Lafayette-FSAE/PacMan/Documentation/ESP32 pinout.png

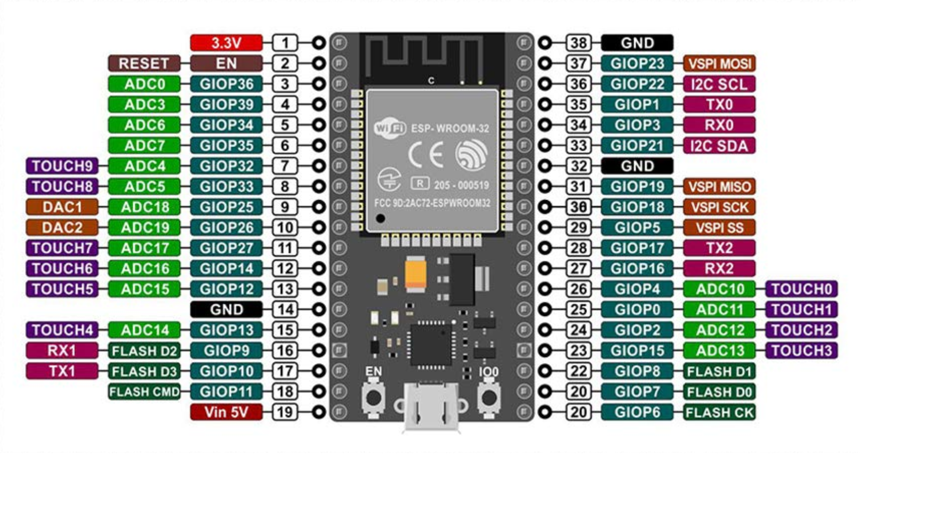
Documentation/ESP32 pinout.png
