Lafayette-FSAE/PacMan/README.md

# PacMan
A KiCad Schematic for PacMan, a Accumulator Management Board for the Lafayette FSAE Accumulator Management System
