Lafayette-FSAE/PacMan/Documentation/PacMan_v_1_3_Render.png

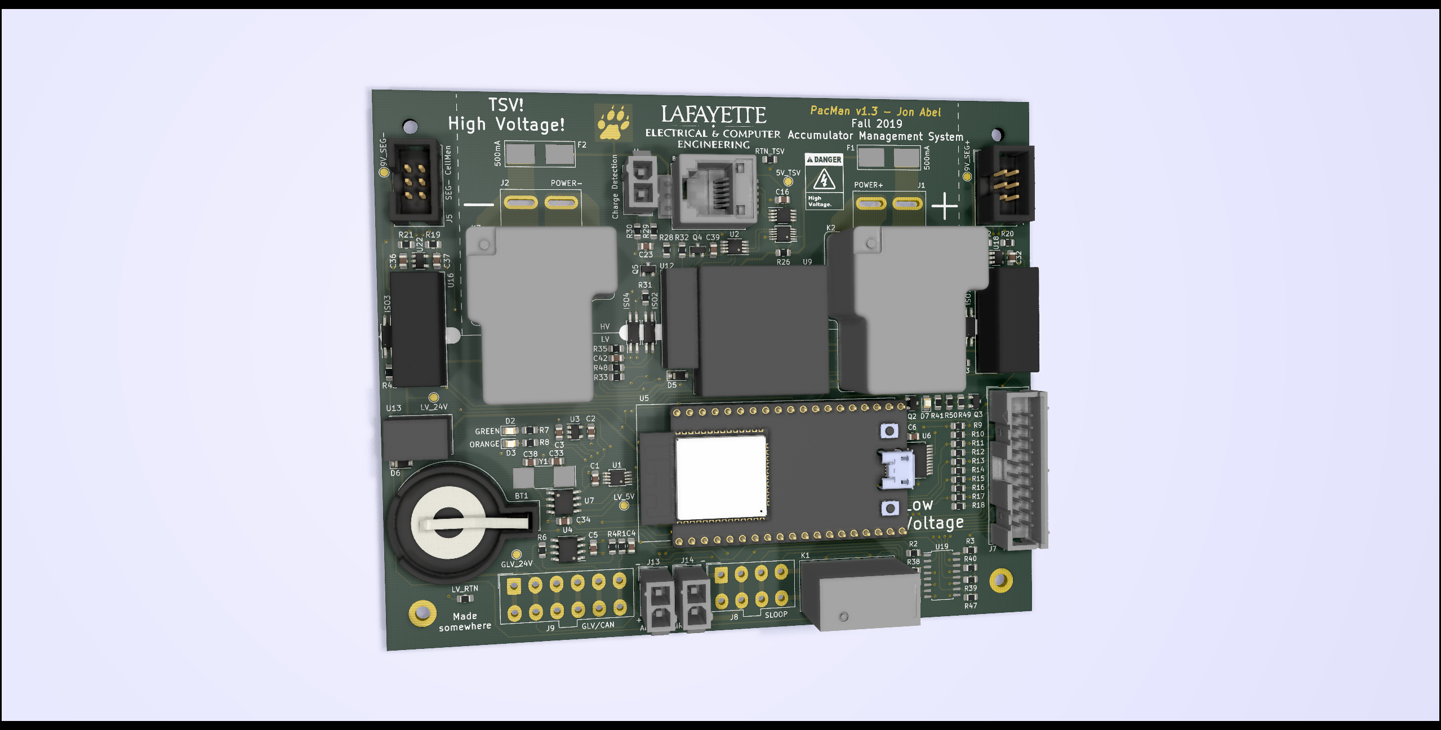
Documentation/PacMan_v_1_3_Render.png
