Lafayette-FSAE/PacMan/Documentation/PacManRender 1.0 Poster.png

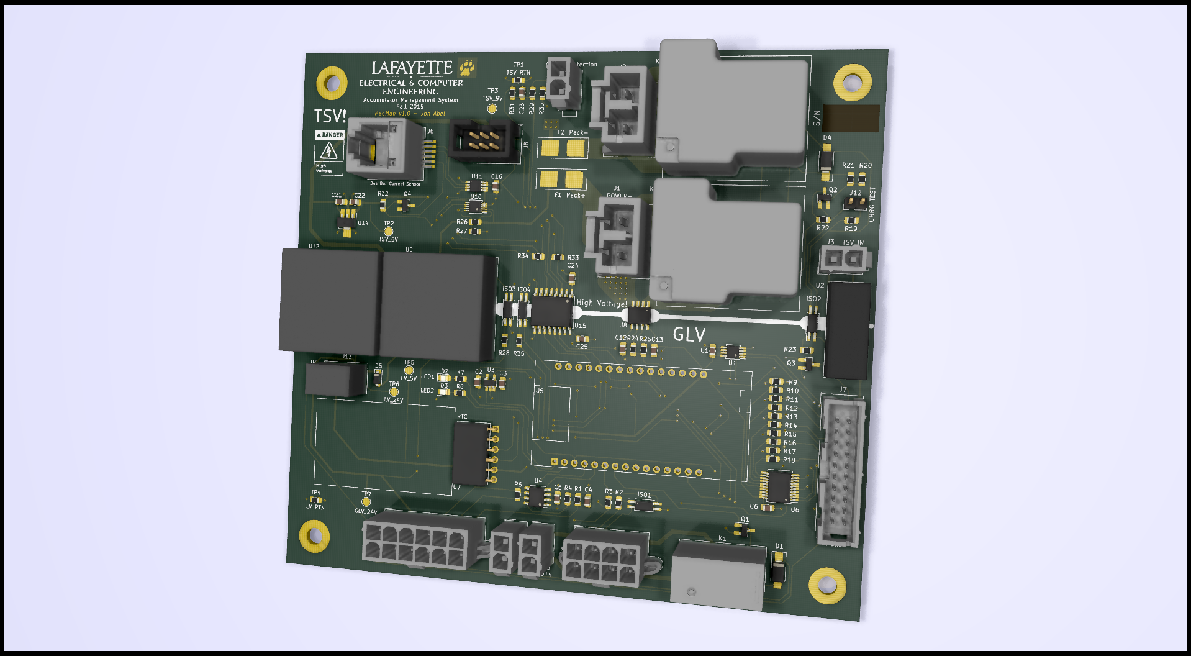
Documentation/PacManRender 1.0 Poster.png
