Lafayette-FSAE/PacMan/Documentation/PacManRender 1.0.png

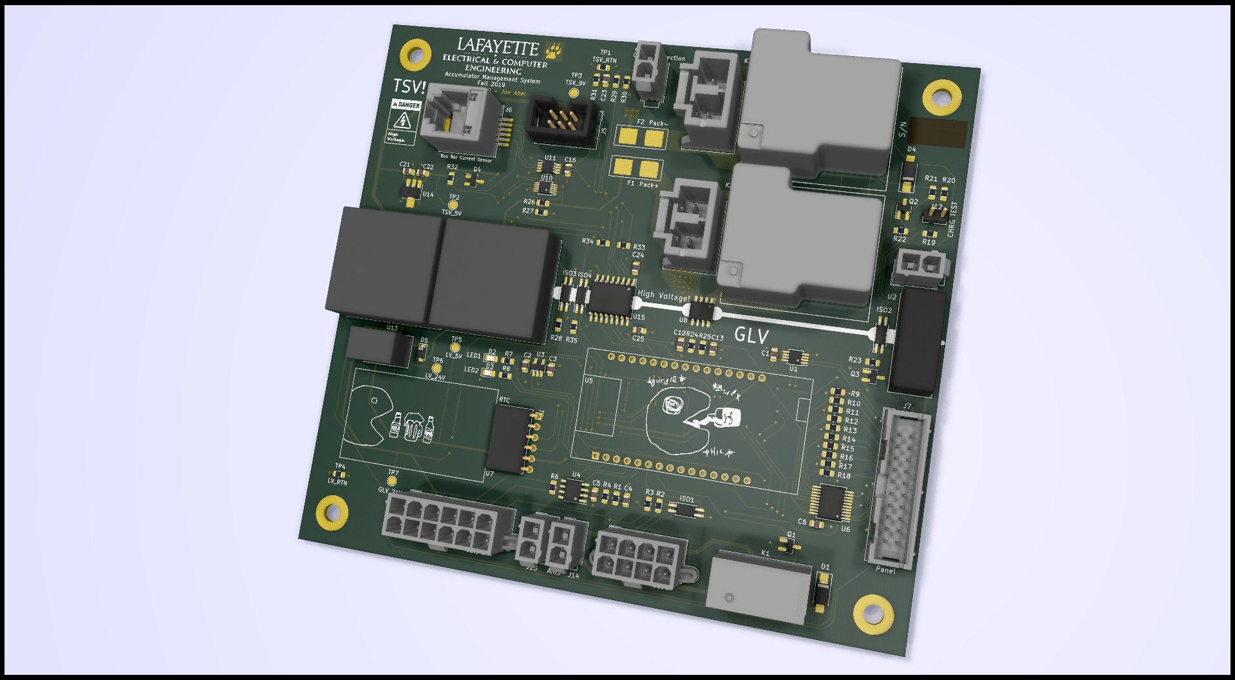
Documentation/PacManRender 1.0.png
