Lafayette-FSAE/PacMan/Documentation/PacMan_v_1_3_BOM.xlsx

BT1 | BR1225 | Battery:BatteryHolder_Keystone_103_1x20mm | Panasonic - BSG | BR-1225 | Digikey | P183-ND | 1
> C4, C42 | C | Capacitor_SMD:C_0805_2012Metric_Pad1.15x1.40mm_HandSolder |  |  |  |  | 2
C12 | 1n/50V | Capacitor_SMD:C_0805_2012Metric_Pad1.15x1.40mm_HandSolder | Samsung Electro-Mechanics | CL21B102KBCNNNC | Digikey | 1276-2425-1-ND | 1
> C13, C30, C34, C36, C40, C41 | 1u/50V | Capacitor_SMD:C_0805_2012Metric_Pad1.15x1.40mm_HandSolder | Samsung Electro-Mechanics | CL21B105KBFNNNG | Digikey | 1276-6470-1-ND | 6
C14 | 4.7u/100V | Capacitor_SMD:C_1210_3225Metric_Pad1.42x2.65mm_HandSolder | Samsung Electro-Mechanics | CL32B475KCVZW6E | Digikey | 1276-7060-1-ND | 1
> C15, C18, C28, C29 | 10u/50V | Capacitor_SMD:C_1210_3225Metric_Pad1.42x2.65mm_HandSolder | Samsung Electro-Mechanics | CL32B106KBJNNWE | Digikey | 1276-3388-1-ND | 4
C19 | 22u/25V | Capacitor_SMD:C_1210_3225Metric_Pad1.42x2.65mm_HandSolder | Samsung Electro-Mechanics | CL32B226KAJNFNE | Digikey | 1276-3391-1-ND | 1
> C24-C27 | 4.7uF/50V | Capacitor_SMD:C_1206_3216Metric_Pad1.42x1.75mm_HandSolder | Samsung Electro-Mechanics | CL31B475KBHNNNE | Digikey | 1276-2789-1-ND | 4
> C32, C37 | 2.2u/25V | Capacitor_SMD:C_0805_2012Metric_Pad1.15x1.40mm_HandSolder | Samsung Electro-Mechanics | CL21B225KAFNFNE | Digikey | 1276-2953-1-ND | 2
> C33, C38 | 20p | Capacitor_SMD:C_0805_2012Metric_Pad1.15x1.40mm_HandSolder | Samsung Electro-Mechanics | CL21C200JBANNNC | Digikey | 1276-1829-1-ND | 2
> C1-C3, C5-C11, C16, C17, C20-C23, C31, C35, C39 | 0.1u/50V | Capacitor_SMD:C_0805_2012Metric_Pad1.15x1.40mm_HandSolder | Samsung Electro-Mechanics | CL21B104KBCNNNC | Digikey | 1276-1003-1-ND | 19
D2 | LED_GREEN | LED_SMD:LED_0805_2012Metric_Pad1.15x1.40mm_HandSolder | Lite-On Inc. | LTST-C170GKT | Digikey | 160-1179-1-ND | 1
D3 | LED_ORANGE | LED_SMD:LED_0805_2012Metric_Pad1.15x1.40mm_HandSolder | Lite-On Inc. | LTST-C171AKT | Digikey | 160-1419-1-ND | 1
> D1, D4 | S1B | Diode_SMD:D_SMA_Handsoldering | Diodes Incorporated | S1B-13-F | Digikey | S1B-FDICT-ND | 2
> D5, D6 | 1N5819HW | Diode_SMD:D_SOD-123 | Diodes Incorporated | 1N5819HW-7-F | Digikey | 1N5819HW-FDICT-ND | 2
D7 | LED_CHRG | LED_SMD:LED_0805_2012Metric_Pad1.15x1.40mm_HandSolder | Lite-On Inc. | LTST-C171AKT | Digikey | 160-1419-1-ND | 1
> F1, F2 | 500mA | Lafayette_Electric_Car_Footprints:0154.500DRL | Littelfuse Inc. | 0154.500DRL | Digikey | F6776CT-ND | 2
> H1, H2 | MountingHole_NoPad_#4 | Lafayette_Electric_Car_Footprints:MountingHole_#4_NoPad |  |  |  |  | 2
> H3, H4 | MountingHole_Pad_#4 | Lafayette_Electric_Car_Footprints:MountingHole_#4_Pad |  |  |  |  | 2
> ISO2-ISO4, ISO7 | TLP293 | Package_SO:SO-4_4.4x2.3mm_P1.27mm | Toshiba Semiconductor | TLP293(GR-TPL,E | Digikey | TLP293(GR-TPLECT-ND | 4
J1 | POWER+ | Lafayette_Electric_Car_Footprints:Powerpole_PP45_FP_1x2 | Anderson Power | 1327FP | Powerwerx | 1327FP | 1
J2 | POWER- | Lafayette_Electric_Car_Footprints:Powerpole_PP45_FP_1x2 | Anderson Power | 1327G6FP | Powerwerx | 1327G6FP | 1
J4 | Charge Detection | Lafayette_Electric_Car_Footprints:Molex_Mini-Fit_Jr_5566-02A_2x01_P4.20mm_Vertical | Molex | 1724470202 | Digikey | WM17931-ND | 1
J5 | SEG- CellMen | Connector_IDC:IDC-Header_2x03_P2.54mm_Vertical | Amphenol ICC | 75869-131LF | Digikey | 609-2845-ND | 1
J6 | BusBar Current Sensor | Lafayette_Electric_Car_Footprints:MOLEX_RJ11 | Molex | 855135002 | Digikey | WM3789CT-ND | 1
J7 | Panel | Lafayette_Electric_Car_Footprints:Amphenol_IDC-Header_2x10_P2.54mm_Vertical | Amphenol ICC | 75869-304LF | Digikey | 609-5118-ND | 1
J8 | SLOOP | Connector_Molex:Molex_Mini-Fit_Jr_5566-08A_2x04_P4.20mm_Vertical | Molex | 39281083 | Digikey | WM3803-ND | 1
J9 | GLV/CAN | Connector_Molex:Molex_Mini-Fit_Jr_5566-12A_2x06_P4.20mm_Vertical | Molex | 39281123 | Digikey | WM3805-ND | 1
J10 | SEG+ CellMen | Connector_IDC:IDC-Header_2x03_P2.54mm_Vertical | Amphenol ICC | 75869-131LF | Digikey | 609-2845-ND | 1
J13 | AIR Left | Lafayette_Electric_Car_Footprints:Molex_Mini-Fit_Jr_5566-02A_2x01_P4.20mm_Vertical | Molex | 1724470202 | Digikey | WM17931-ND | 1
J14 | AIR Right | Lafayette_Electric_Car_Footprints:Molex_Mini-Fit_Jr_5566-02A_2x01_P4.20mm_Vertical | Molex | 1724470202 | Digikey | WM17931-ND | 1
K1 | G5Q-1A4 DC24 | Lafayette_Electric_Car_Footprints:G5Q-1A4 | Omron Electronics | G5Q-1A4 DC24 | Digikey | Z224-ND | 1
> K2, K3 | T9AS1D12-24 | Lafayette_Electric_Car_Footprints:T9AS1D12 | TE Connectivity | T9AS1D12-24 | Digikey | PB303-ND | 2
LOGO1 | LafECEDepLogo | Lafayette_Electric_Car_Footprints:ECE_Logo_Jon |  |  |  |  | 1
LOGO2 | LeopardPawLogo | Lafayette_Electric_Car_Footprints:paw_solder_mask_bigly |  |  |  |  | 1
LOGO3 | DangerHighVoltageLogo | Lafayette_Electric_Car_Footprints:highvoltagesmall |  |  |  |  | 1
> Q1, Q2 | DMN3730U | Package_TO_SOT_SMD:SOT-23 | Diodes Incorporated | DMN3730U-7 | Digikey | DMN3730U-7DICT-ND | 2
> Q3-Q5 | DMP10H4D2S | Package_TO_SOT_SMD:SOT-23 | Diodes Incorporated | DMP10H4D2S-7 | Digikey | DMP10H4D2S-7DICT-ND | 3
R1 | 1M | Resistor_SMD:R_0805_2012Metric_Pad1.15x1.40mm_HandSolder |  |  |  |  | 1
R6 | 120 | Resistor_SMD:R_0805_2012Metric_Pad1.15x1.40mm_HandSolder |  |  |  |  | 1
> R7, R8, R42, R43 | 270 | Resistor_SMD:R_0805_2012Metric_Pad1.15x1.40mm_HandSolder |  |  |  |  | 4
> R9, R11, R13, R15, R17, R28 | 100k | Resistor_SMD:R_0805_2012Metric_Pad1.15x1.40mm_HandSolder |  |  |  |  | 6
> R19-R23, R27, R44, R45 | 3.3k | Resistor_SMD:R_0805_2012Metric_Pad1.15x1.40mm_HandSolder |  |  |  |  | 8
> R3, R24, R32, R33, R36, R37, R39, R40, R47 | 10k | Resistor_SMD:R_0805_2012Metric_Pad1.15x1.40mm_HandSolder |  |  |  |  | 9
R25 | 22k | Resistor_SMD:R_0805_2012Metric_Pad1.15x1.40mm_HandSolder |  |  |  |  | 1
R26 | 0.82 | Resistor_SMD:R_0805_2012Metric_Pad1.15x1.40mm_HandSolder | Panasonic Electronic Components | ERJ-6DQFR82V | Digikey | P19306CT-ND | 1
> R29, R30 | 5k | Resistor_SMD:R_0805_2012Metric_Pad1.15x1.40mm_HandSolder |  |  |  |  | 2
R31 | 330 | Resistor_SMD:R_0805_2012Metric_Pad1.15x1.40mm_HandSolder |  |  |  |  | 1
R34 | 470 | Resistor_SMD:R_0805_2012Metric_Pad1.15x1.40mm_HandSolder |  |  |  |  | 1
> R2, R5, R35, R38, R46 | 5.1k | Resistor_SMD:R_0805_2012Metric_Pad1.15x1.40mm_HandSolder |  |  |  |  | 5
> R4, R10, R12, R14, R16, R18, R41 | 1k | Resistor_SMD:R_0805_2012Metric_Pad1.15x1.40mm_HandSolder |  |  |  |  | 7
R48 | R | Resistor_SMD:R_0805_2012Metric_Pad1.15x1.40mm_HandSolder |  |  |  |  | 1
> R49, R50 | 4.7k | Resistor_SMD:R_0805_2012Metric_Pad1.15x1.40mm_HandSolder |  |  |  |  | 2
TP1 | 5V_SEG- | TestPoint:TestPoint_Pad_D1.5mm |  |  |  |  | 1
TP2 | RTN_SEG- | Resistor_SMD:R_0805_2012Metric_Pad1.15x1.40mm_HandSolder | TE Connectivity | RCT-0C | Digikey | A106144CT-ND | 1
TP3 | 9V_SEG- | TestPoint:TestPoint_Pad_D1.5mm |  |  |  |  | 1
TP4 | LV_RTN | Resistor_SMD:R_0805_2012Metric_Pad1.15x1.40mm_HandSolder | TE Connectivity | RCT-0C | Digikey | A106144CT-ND | 1
TP5 | LV_5V | TestPoint:TestPoint_Pad_D1.5mm |  |  |  |  | 1
TP6 | LV_24V | TestPoint:TestPoint_Pad_D1.5mm |  |  |  |  | 1
TP7 | GLV_24V | TestPoint:TestPoint_Pad_D1.5mm |  |  |  |  | 1
TP8 | SDA | TestPoint:TestPoint_Pad_D1.5mm |  |  |  |  | 1
TP9 | SCL | TestPoint:TestPoint_Pad_D1.5mm |  |  |  |  | 1
TP10 | 5V_TSV | TestPoint:TestPoint_Pad_D1.5mm |  |  |  |  | 1
TP11 | RTN_TSV | Resistor_SMD:R_0805_2012Metric_Pad1.15x1.40mm_HandSolder | TE Connectivity | RCT-0C | Digikey | A106144CT-ND | 1
TP12 | 9V_SEG+ | TestPoint:TestPoint_Pad_D1.5mm |  |  |  |  | 1
TP13 | 5V_SEG+ | TestPoint:TestPoint_Pad_D1.5mm |  |  |  |  | 1
TP14 | RTN_SEG+ | Resistor_SMD:R_0805_2012Metric_Pad1.15x1.40mm_HandSolder | TE Connectivity | RCT-0C | Digikey | A106144CT-ND | 1
> U1, U2 | MCP9804 | Package_SO:MSOP-8_3x3mm_P0.65mm | Microchip Technology | MCP9804T-E/MS | Digikey | MCP9804T-E/MSCT-ND | 2
U3 | ADM6320 | Package_TO_SOT_SMD:SOT-23-5 | Analog Devices Inc. | ADM6320CY29ARJZ-R7 | Digikey | ADM6320CY29ARJZ-R7CT-ND | 1
U4 | MCP2551-I-SN | Package_SO:SOIC-8_3.9x4.9mm_P1.27mm | Microchip Technology | MCP2551T-I/SN | Digikey | MCP2551T-I/SNCT-ND | 1
U5 | ESP32_DEVKITC | Lafayette_Electric_Car_Footprints:MODULE_ESP32-DEVKITC-32D | Espressif Systems | ESP32-DEVKITC-32D | Digikey | 1965-1000-ND | 1
U6 | MCP23008 | Package_SO:SSOP-20_5.3x7.2mm_P0.65mm | Microchip Technology | MCP23008T-E/SS | Digikey | MCP23008T-E/SSCT-ND | 1
U7 | BQ32002 | Package_SO:SOIC-8_3.9x4.9mm_P1.27mm | Texas Instruments | BQ32002DR | Digikey | 296-41071-1-ND | 1
U8 | ACHS-7122 | Package_SO:SO-8_3.9x4.9mm_P1.27mm | Broadcom Limited | ACHS-7122-000E | Digikey | 516-4081-ND | 1
U9 | PDQE10-Q48-S24-D | Lafayette_Electric_Car_Footprints:PDQE10-DIP6 | CUI Inc. | PDQE10-Q48-S24-D | Digikey | 102-4874-ND | 1
U10 | LTC4151 | Package_SO:MSOP-10_3x3mm_P0.5mm | Linear Technology/Analog Devices | LTC4151IMS#TRPBF | Digikey | LTC4151IMS#TRPBFCT-ND | 1
U11 | INA592 | Package_SO:VSSOP-8_3.0x3.0mm_P0.65mm | Texas Instruments | INA592IDGKR | Digikey | 296-INA592IDGKRCT-ND | 1
U12 | MEF1S2405SP3C | Lafayette_Electric_Car_Footprints:MEF1S2405SP3C | Murata Power Solutions Inc. | MEF1S2405SP3C | Digikey | 811-2932-5-ND | 1
U13 | V7805-500 | Lafayette_Electric_Car_Footprints:VX7805-500 | CUI Inc. | V7805-500 | Digikey | 102-1709-ND | 1
> U14, U15, U21 | Si8600AC | Package_SO:SO-8_3.9x4.9mm_P1.27mm | Silicon Labs | SI8600AC-B-ISR | Digikey | SI8600AC-B-ISRCT-ND | 3
> U16, U17 | TEC3-2419 | Lafayette_Electric_Car_Footprints:TEC3-2419 | Traco Power | TEC 3-2419 | Digikey | 1951-1481-ND | 2
> U18, U22 | AP2204K-5.0 | Package_TO_SOT_SMD:SOT-23-5 | Diodes Incorporated | AP2204K-5.0TRG1 | Digikey | AP2204K-5.0TRG1DICT-ND | 2
U19 | TLP293-4 | Package_SO:SOIC-16_4.55x10.3mm_P1.27mm | Toshiba Semiconductor | TLP293-4 | Digikey |  | 1
Y1 | 32K | Crystal:Crystal_SMD_SeikoEpson_MC405-2Pin_9.6x4.1mm | Seiko Epson | MC-405 32.7680K-A0:ROHS | Digikey | SER2405CT-ND | 1
