Lafayette-FSAE/PacMan/Documentation/BOM 1.0.xlsx

C4 | C | Capacitor_SMD:C_0805_2012Metric_Pad1.15x1.40mm_HandSolder | ~ |  |  |  |  | 1
> C1-C3, C5-C11, C16, C22-C25 | 0.1u/50V | Capacitor_SMD:C_0805_2012Metric_Pad1.15x1.40mm_HandSolder | http://www.samsungsem.com/kr/support/product-search/mlcc/__icsFiles/afieldfile/2019/06/18/CL21B104KBCNNNC-19.pdf | Samsung Electro-Mechanics | CL21B104KBCNNNC | Digikey | 1276-1003-1-ND | 15
C12 | 1n/50V | Capacitor_SMD:C_0805_2012Metric_Pad1.15x1.40mm_HandSolder | http://www.samsungsem.com/kr/support/product-search/mlcc/__icsFiles/afieldfile/2019/06/18/CL21B102KBCNNNC-19.pdf | Samsung Electro-Mechanics | CL21B102KBCNNNC | Digikey | 1276-2425-1-ND | 1
C13 | 1u/50V | Capacitor_SMD:C_0805_2012Metric_Pad1.15x1.40mm_HandSolder | http://www.samsungsem.com/kr/support/product-search/mlcc/__icsFiles/afieldfile/2019/06/18/CL21B105KBFNNNG-19.pdf | Samsung Electro-Mechanics | CL21B105KBFNNNG | Digikey | 1276-6470-1-ND | 1
C14 | 4.7u/100V | Capacitor_SMD:C_0805_2012Metric_Pad1.15x1.40mm_HandSolder | http://www.samsungsem.com/kr/support/library/product-catalog/__icsFiles/afieldfile/2018/11/28/MLCC.pdf | Samsung Electro-Mechanics | CL32B475KCVZW6E | Digikey | 1276-7060-1-ND | 1
> C15, C18, C20 | 10u/50V | Capacitor_SMD:C_1210_3225Metric_Pad1.42x2.65mm_HandSolder | http://www.samsungsem.com/kr/support/product-search/mlcc/__icsFiles/afieldfile/2019/06/18/CL32B106KBJNNWE-19.pdf | Samsung Electro-Mechanics | CL32B106KBJNNWE | Digikey | 1276-3388-1-ND | 3
C17 | 22u/50V | Capacitor_SMD:C_0805_2012Metric_Pad1.15x1.40mm_HandSolder | http://www.samsungsem.com/kr/support/product-search/mlcc/__icsFiles/afieldfile/2019/05/10/19-CL21A475KBQNNNE.pdf | Samsung Electro-Mechanics | CL21A475KBQNNNE | Digikey | 1276-1248-1-ND | 1
C19 | 22u/25V | Capacitor_SMD:C_1210_3225Metric_Pad1.42x2.65mm_HandSolder | http://www.samsungsem.com/kr/support/product-search/mlcc/__icsFiles/afieldfile/2019/06/18/CL32B226KAJNFNE-19.pdf | Samsung Electro-Mechanics | CL32B226KAJNFNE | Digikey | 1276-3391-1-ND | 1
C21 | 0.33u/50V | Capacitor_SMD:C_0805_2012Metric_Pad1.15x1.40mm_HandSolder | http://www.samsungsem.com/kr/support/product-search/mlcc/__icsFiles/afieldfile/2019/06/18/CL21B334KBFNNNE-19.pdf | Samsung Electro-Mechanics | CL21B334KBFNNNE | Digikey | 1276-1123-1-ND | 1
> D1, D4 | S1B | Diode_SMD:D_SMA_Handsoldering | https://www.diodes.com/assets/Datasheets/ds16003.pdf | Diodes Incorporated | S1B-13-F | Digikey | S1B-FDICT-ND | 2
D2 | LED_GREEN | LED_SMD:LED_0805_2012Metric_Pad1.15x1.40mm_HandSolder | https://media.digikey.com/pdf/Data%20Sheets/Lite-On%20PDFs/LTST-C170GKT.pdf | Lite-On Inc. | LTST-C170GKT | Digikey | 160-1179-1-ND | 1
D3 | LED_ORANGE | LED_SMD:LED_0805_2012Metric_Pad1.15x1.40mm_HandSolder | http://optoelectronics.liteon.com/upload/download/DS-22-99-0170/LTST-C171AKT.pdf | Lite-On Inc. | LTST-C171AKT | Digikey | 160-1419-1-ND | 1
> D5, D6 | 1N5819HW | Diode_SMD:D_SOD-123 | https://www.diodes.com/assets/Datasheets/ds30217.pdf | Diodes Incorporated | 1N5819HW-7-F | Digikey | 1N5819HW-FDICT-ND | 2
F1 | Pack+ | Lafayette_Electric_Car_Footprints:0154.500DRL | https://www.littelfuse.com/~/media/electronics/datasheets/fuses/littelfuse_fuse_154_154t_154l_154tl_datasheet.pdf.pdf | Littelfuse Inc. | 0154.500DRL | Digikey | F6776CT-ND | 1
F2 | Pack- | Lafayette_Electric_Car_Footprints:0154.500DRL | https://www.littelfuse.com/~/media/electronics/datasheets/fuses/littelfuse_fuse_154_154t_154l_154tl_datasheet.pdf.pdf | Littelfuse Inc. | 0154.500DRL | Digikey | F6776CT-ND | 1
> H1-H4 | MountingHole_Pad | MountingHole:MountingHole_4.3mm_M4_Pad | ~ |  |  |  |  | 4
> ISO1-ISO4 | TLP293 | Package_SO:SO-4_4.4x2.3mm_P1.27mm | https://toshiba.semicon-storage.com/info/docget.jsp?did=14419&prodName=TLP293 | Toshiba Semiconductor | TLP293(GR-TPL,E | Digikey | TLP293(GR-TPLECT-ND | 4
J1 | POWER+ | Lafayette_Electric_Car_Footprints:DF22-2P-7.92 | https://www.hirose.com/product/document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 | Hirose Electric Co | DF22L-2P-7.92DSA(05) | Digikey | H10722-ND | 1
J2 | POWER- | Lafayette_Electric_Car_Footprints:DF22-2P-7.92 | https://www.hirose.com/product/document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 | Hirose Electric Co | DF22R-2P-7.92DSA(05) | Digikey | H10718-ND | 1
J3 | TSV IN | Lafayette_Electric_Car_Footprints:Molex_Mini-Fit_Jr_5566-02A_2x01_P4.20mm_Vertical | https://www.molex.com/webdocs/datasheets/pdf/en-us/1724470202_PCB_HEADERS.pdf | Molex | 1724470202 | Digikey | WM17931-ND | 1
J4 | Charge Detection | Lafayette_Electric_Car_Footprints:Molex_Mini-Fit_Jr_5566-02A_2x01_P4.20mm_Vertical | https://www.molex.com/webdocs/datasheets/pdf/en-us/1724470202_PCB_HEADERS.pdf | Molex | 1724470202 | Digikey | WM17931-ND | 1
J5 | CellMen | Connector_IDC:IDC-Header_2x03_P2.54mm_Vertical | https://cdn.amphenol-icc.com/media/wysiwyg/files/drawing/75869.pdf | Amphenol ICC | 75869-131LF | Digikey | 609-2845-ND | 1
J6 | RJ12 | Lafayette_Electric_Car_Footprints:MOLEX_RJ11 | https://www.molex.com/pdm_docs/sd/855135002_sd.pdf | Molex | 855135002 | Digikey | WM3789CT-ND | 1
J7 | Panel | Lafayette_Electric_Car_Footprints:Amphenol_IDC-Header_2x10_P2.54mm_Vertical | https://cdn.amphenol-icc.com/media/wysiwyg/files/drawing/75869.pdf | Amphenol ICC | 75869-304LF | Digikey | 609-5118-ND | 1
J8 | SLOOP | Lafayette_Electric_Car_Footprints:Molex_Mini-Fit_Jr_5566-08A2_2x04_P4.20mm_Vertical | https://www.molex.com/pdm_docs/sd/1724470002_sd.pdf | Molex | 1724470008 | Digikey | WM20746-ND | 1
J9 | GLV/CAN | Lafayette_Electric_Car_Footprints:Molex_Mini-Fit_Jr_5566-12A2_2x06_P4.20mm_Vertical | https://www.molex.com/pdm_docs/sd/462070012_sd.pdf | Molex | 462070012 | Digikey | 23-0462070012-ND | 1
J12 | CHRG TEST | Connector_PinHeader_2.54mm:PinHeader_1x02_P2.54mm_Vertical | ~ |  |  |  |  | 1
J13 | AIR Left | Lafayette_Electric_Car_Footprints:Molex_Mini-Fit_Jr_5566-02A_2x01_P4.20mm_Vertical | https://www.molex.com/webdocs/datasheets/pdf/en-us/1724470202_PCB_HEADERS.pdf | Molex | 1724470202 | Digikey | WM17931-ND | 1
J14 | AIR Right | Lafayette_Electric_Car_Footprints:Molex_Mini-Fit_Jr_5566-02A_2x01_P4.20mm_Vertical | https://www.molex.com/webdocs/datasheets/pdf/en-us/1724470202_PCB_HEADERS.pdf | Molex | 1724470202 | Digikey | WM17931-ND | 1
K1 | G5Q-1A4 DC24 | Lafayette_Electric_Car_Footprints:G5Q-1A4 | https://omronfs.omron.com/en_US/ecb/products/pdf/en-g5q.pdf | Omron Electronics | G5Q-1A4 DC24 | Digikey | Z224-ND | 1
> K2, K3 | T9AS1D12-48 | Lafayette_Electric_Car_Footprints:T9AS1D12 | https://www.te.com/commerce/DocumentDelivery/DDEController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 | TE Connectivity | T9AS1D12-48 | Digikey | PB1013-ND | 2
LOGO1 | LafECEDepLogo | Lafayette_Electric_Car_Footprints:ECE_Logo_Jon |  |  |  |  |  | 1
LOGO2 | LeopardPawLogo | Lafayette_Electric_Car_Footprints:paw_solder_mask_larger |  |  |  |  |  | 1
LOGO3 | DangerHighVoltageLogo | Lafayette_Electric_Car_Footprints:highvoltagesmall |  |  |  |  |  | 1
> Q1, Q3 | BSS123 | Package_TO_SOT_SMD:SOT-23_Handsoldering | https://www.diodes.com/assets/Datasheets/ds30366.pdf | Diodes Incorporated | BSS123-7-F | Digikey | BSS123-FDICT-ND | 2
> Q2, Q4 | DMP10H4D2S | Package_TO_SOT_SMD:SOT-23_Handsoldering | https://www.diodes.com/assets/Datasheets/DMP10H4D2S.pdf | Diodes Incorporated | DMP10H4D2S-7 | Digikey | DMP10H4D2S-7DICT-ND | 2
R1 | 1M | Resistor_SMD:R_0805_2012Metric_Pad1.15x1.40mm_HandSolder | ~ |  |  |  |  | 1
> R2, R28, R33-R37 | 4.7k | Resistor_SMD:R_0805_2012Metric_Pad1.15x1.40mm_HandSolder | ~ |  |  |  |  | 7
> R3, R24, R32 | 10k | Resistor_SMD:R_0805_2012Metric_Pad1.15x1.40mm_HandSolder | ~ |  |  |  |  | 3
> R4, R10, R12, R14, R16, R18, R22 | 1k | Resistor_SMD:R_0805_2012Metric_Pad1.15x1.40mm_HandSolder | ~ |  |  |  |  | 7
R6 | 120 | Resistor_SMD:R_0805_2012Metric_Pad1.15x1.40mm_HandSolder | ~ |  |  |  |  | 1
> R7, R8 | 270 | Resistor_SMD:R_0805_2012Metric_Pad1.15x1.40mm_HandSolder | ~ |  |  |  |  | 2
> R9, R11, R13, R15, R17 | 100k | Resistor_SMD:R_0805_2012Metric_Pad1.15x1.40mm_HandSolder | ~ |  |  |  |  | 5
R19 | 15k | Resistor_SMD:R_0805_2012Metric_Pad1.15x1.40mm_HandSolder | ~ |  |  |  |  | 1
> R20, R21 | 560 | Resistor_SMD:R_0805_2012Metric_Pad1.15x1.40mm_HandSolder | ~ |  |  |  |  | 2
R23 | 390 | Resistor_SMD:R_0805_2012Metric_Pad1.15x1.40mm_HandSolder | ~ |  |  |  |  | 1
R25 | 22k | Resistor_SMD:R_0805_2012Metric_Pad1.15x1.40mm_HandSolder | ~ |  |  |  |  | 1
R26 | 0.82 | Resistor_SMD:R_0805_2012Metric_Pad1.15x1.40mm_HandSolder | https://industrial.panasonic.com/cdbs/www-data/pdf/RDN0000/AOA0000C313.pdf | Panasonic Electronic Components | ERJ-6DQFR82V | Digikey | P19306CT-ND | 1
R27 | R | Resistor_SMD:R_0805_2012Metric_Pad1.15x1.40mm_HandSolder | ~ |  |  |  |  | 1
> R29, R30 | 5k | Resistor_SMD:R_0805_2012Metric_Pad1.15x1.40mm_HandSolder | ~ |  |  |  |  | 2
R31 | 500k | Resistor_SMD:R_0805_2012Metric_Pad1.15x1.40mm_HandSolder | ~ |  |  |  |  | 1
TP1 | TP_TSV_RTN | Resistor_SMD:R_0805_2012Metric_Pad1.15x1.40mm_HandSolder | https://www.te.com/commerce/DocumentDelivery/DDEController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 | TE Connectivity | RCT-0C | Digikey | A106144CT-ND | 1
TP2 | TP_TSV_5V | TestPoint:TestPoint_Pad_D2.0mm | ~ |  |  |  |  | 1
TP3 | TP_TSV_9V | TestPoint:TestPoint_Pad_D2.0mm | ~ |  |  |  |  | 1
TP4 | TP_LV_RTN | Resistor_SMD:R_0805_2012Metric_Pad1.15x1.40mm_HandSolder | https://www.te.com/commerce/DocumentDelivery/DDEController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 | TE Connectivity | RCT-0C | Digikey | A106144CT-ND | 1
TP5 | TP_LV_5V | TestPoint:TestPoint_Pad_D2.0mm | ~ |  |  |  |  | 1
TP6 | TP_LV_24V | TestPoint:TestPoint_Pad_D2.0mm | ~ |  |  |  |  | 1
TP7 | TP_GLV_24V | TestPoint:TestPoint_Pad_D2.0mm | ~ |  |  |  |  | 1
U1 | MCP9804 | Package_SO:MSOP-8_3x3mm_P0.65mm | http://ww1.microchip.com/downloads/en/DeviceDoc/22203b.pdf | Microchip Technology | MCP9804T-E/MS | Digikey | MCP9804T-E/MSCT-ND | 1
U2 | TEC2-4815WI | Lafayette_Electric_Car_Footprints:TEC2-4815 | https://www.tracopower.com/products/tec2wi.pdf | Traco Power | TEC 2-4815WI | Digikey | 1951-1435-ND | 1
U3 | ADM6320 | Package_TO_SOT_SMD:SOT-23-5_HandSoldering | https://www.analog.com/media/en/technical-documentation/data-sheets/ADM6316_6318_6319_6320_6321_6322.pdf | Analog Devices Inc. | ADM6320CY29ARJZ-R7 | Digikey | ADM6320CY29ARJZ-R7CT-ND | 1
U4 | MCP2551-I-SN | Package_SO:SOIC-8_3.9x4.9mm_P1.27mm | http://ww1.microchip.com/downloads/en/devicedoc/21667d.pdf | Microchip Technology | MCP2551T-I/SN | Digikey | MCP2551T-I/SNCT-ND | 1
U5 | ESP32_TTGO_PSRAM | Lafayette_Electric_Car_Footprints:ESP32TTGOT8 | https://www.amazon.com/TTGO-ESP32-PSRAM-Antenna-Bluetooth/dp/B07B6NM1RY |  |  |  |  | 1
U6 | MCP23008 | Package_SO:SSOP-20_5.3x7.2mm_P0.65mm | https://www.mouser.com/datasheet/2/268/21919b-65915.pdf | Microchip Technology | MCP23008T-E/SS | Digikey | MCP23008T-E/SSCT-ND | 1
U7 | RTC | Connector_PinSocket_2.54mm:PinSocket_1x06_P2.54mm_Horizontal | ~ |  |  |  |  | 1
U8 | ACHS-7122 | Package_SO:SO-8_3.9x4.9mm_P1.27mm | https://www.mouser.com/datasheet/2/678/ACHS-712x-DS101_2018-02-28-1386725.pdf | Broadcom Limited | ACHS-7122-000E | Digikey | 516-4081-ND | 1
U9 | PDQE10-Q48-S24-D | Lafayette_Electric_Car_Footprints:PDQE10-DIP6 | https://www.cui.com/product/resource/pdqe10-d.pdf | CUI Inc. | PDQE10-Q48-S24-D | Digikey | 102-4874-ND | 1
U10 | LTC4151 | Package_SO:MSOP-10_3x3mm_P0.5mm | https://www.analog.com/media/en/technical-documentation/data-sheets/4151ff.pdf | Linear Technology/Analog Devices | LTC4151IMS#TRPBF | Digikey | LTC4151IMS#TRPBFCT-ND | 1
U11 | INA592 | Package_SO:VSSOP-8_3.0x3.0mm_P0.65mm | http://www.ti.com/lit/ds/symlink/ina592.pdf | Texas Instruments | INA592IDGKR | Digikey | 296-INA592IDGKRCT-ND | 1
U12 | PDQE10-Q24-S9-D | Lafayette_Electric_Car_Footprints:PDQE10-DIP6 | https://www.cui.com/product/resource/pdqe10-d.pdf | CUI Inc. | PDQE10-Q24-S9-D | Digikey | 102-4862-ND | 1
U13 | V7805-500 | Lafayette_Electric_Car_Footprints:VX7805-500 | https://www.cui.com/product/resource/v78-500.pdf | CUI Inc. | V7805-500 | Digikey | 102-1709-ND | 1
U14 | L78L05_SOT89 | Package_TO_SOT_SMD:SOT-89-3_Handsoldering | http://www.st.com/content/ccc/resource/technical/document/datasheet/15/55/e5/aa/23/5b/43/fd/CD00000446.pdf/files/CD00000446.pdf/jcr:content/translations/en.CD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 | STMicroelectronics | L78L05ACUTR | Digikey | 497-1183-1-ND | 1
U15 | Si8605AD-B-IS | Package_SO:SOIC-16W_7.5x10.3mm_P1.27mm | https://www.silabs.com/documents/public/data-sheets/Si860x.pdf | Silicon Labs | SI8605AD-B-ISR | Digikey | 336-4928-1-ND | 1
