Lafayette-FSAE/PacMan/3DModels/Anderson_2x1.step

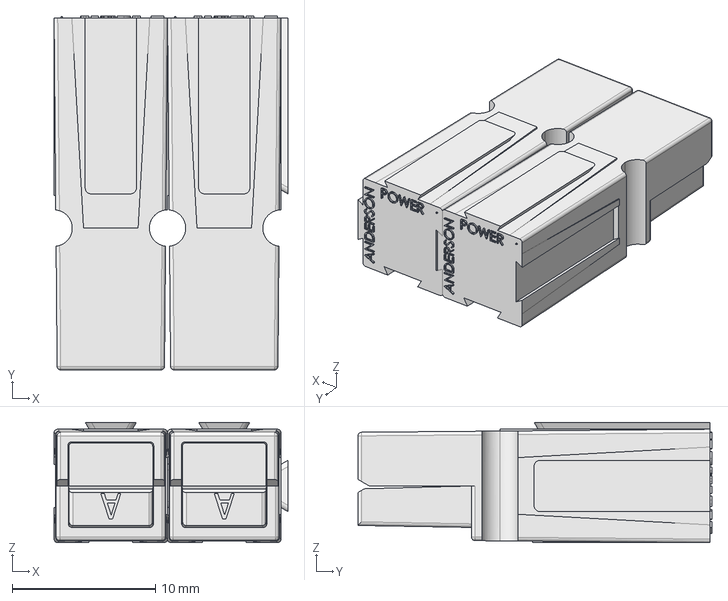
[picture p5: CAD file, 2020-04-14]
3DModels/Anderson_2x1.step
16.3 x 24.7 x 8.41 mm
