Lafayette-FSAE/PacMan/3DModels/mps_dcdc_mef1s_sp3c_a.step

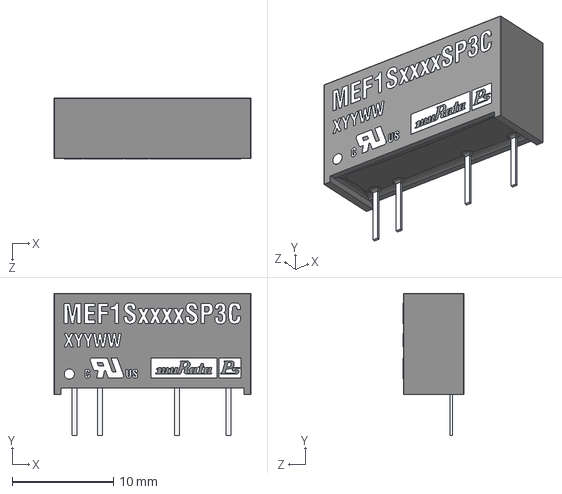
[picture p6: CAD file, 2020-02-20]
3DModels/mps_dcdc_mef1s_sp3c_a.step
19.5 x 14.1 x 6.02 mm
