Lafayette-FSAE/PacMan/3DModels/tec3-3d-drawing.step

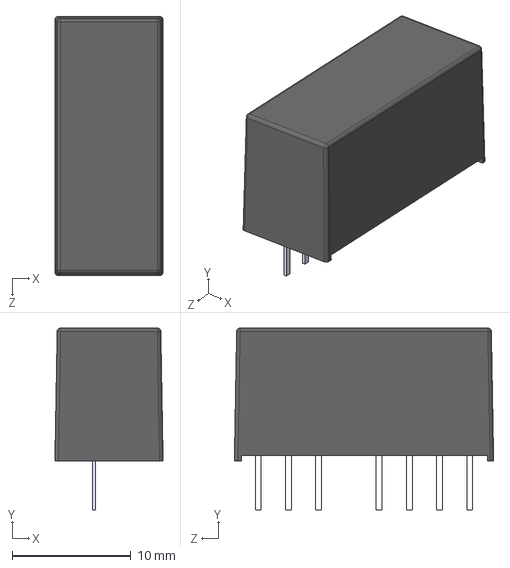
[picture p7: CAD file, 2020-01-10]
3DModels/tec3-3d-drawing.step
9.10 x 15.3 x 21.8 mm
