Lafayette-FSAE/PacMan/3DModels/CUI_VIFSD1-S24-S5-SIP.step

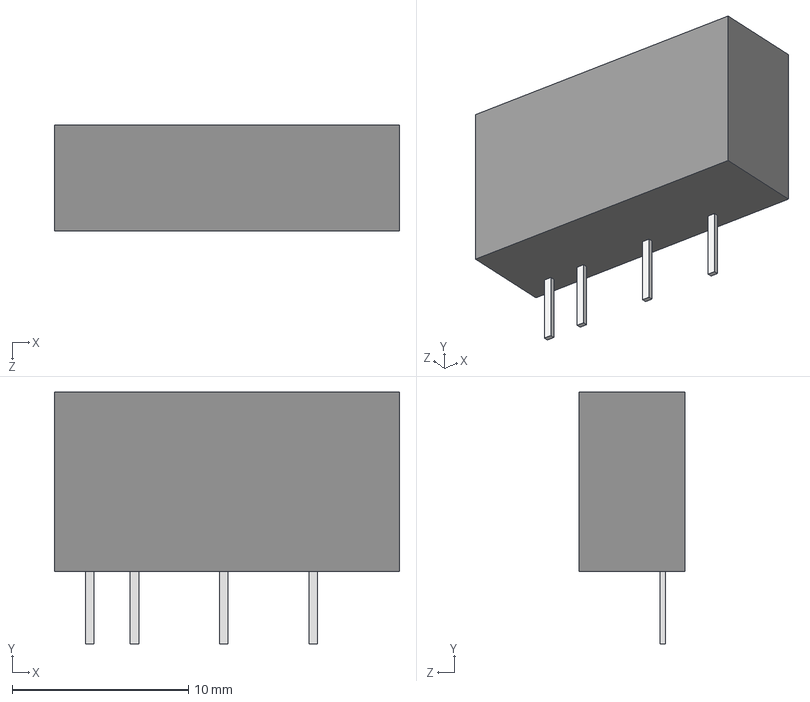
[picture p8: CAD file, 2020-01-10]
3DModels/CUI_VIFSD1-S24-S5-SIP.step
19.6 x 14.3 x 6.00 mm
