Lafayette-FSAE/PacMan/3DModels/molex_rj11.stp

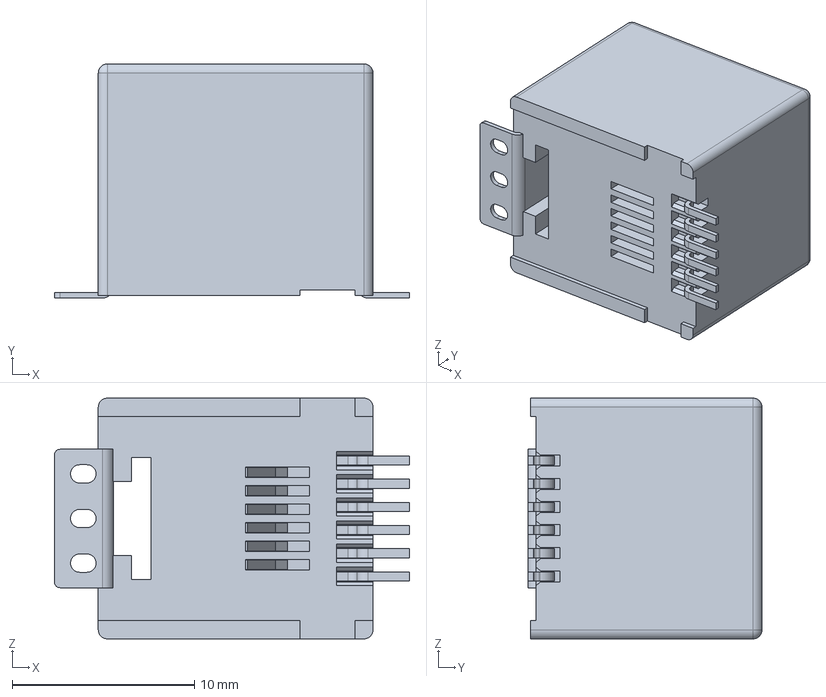
[picture p9: CAD file, 2019-11-18]
3DModels/molex_rj11.stp
19.5 x 12.8 x 13.2 mm
