Lafayette-FSAE/PacMan/3DModels/molex_mini_fit_jr_2x4.stp

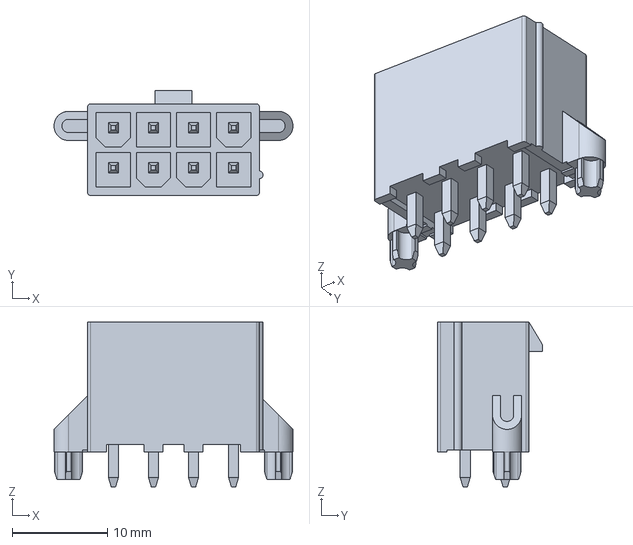
[picture p10: CAD file, 2019-11-18]
3DModels/molex_mini_fit_jr_2x4.stp
25.1 x 11.0 x 17.3 mm
