Lafayette-FSAE/PacMan/3DModels/molex_mini_fit_jr_2x6.stp

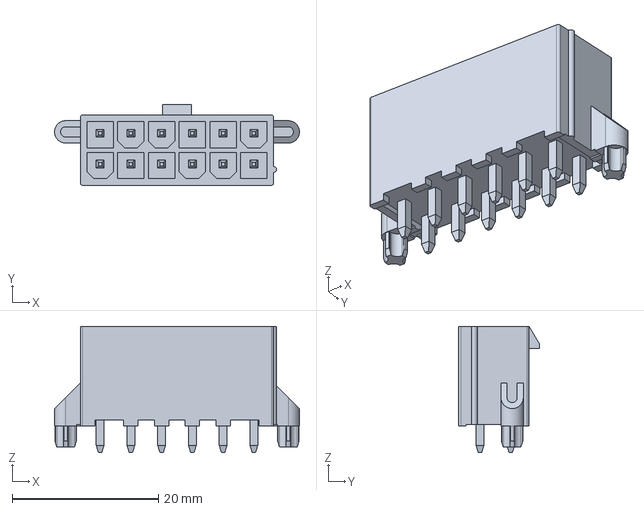
[picture p11: CAD file, 2019-11-18]
3DModels/molex_mini_fit_jr_2x6.stp
33.5 x 11.0 x 17.3 mm
