Lafayette-FSAE/PacMan/3DModels/molex_mini_fit_jr_2x1.stp

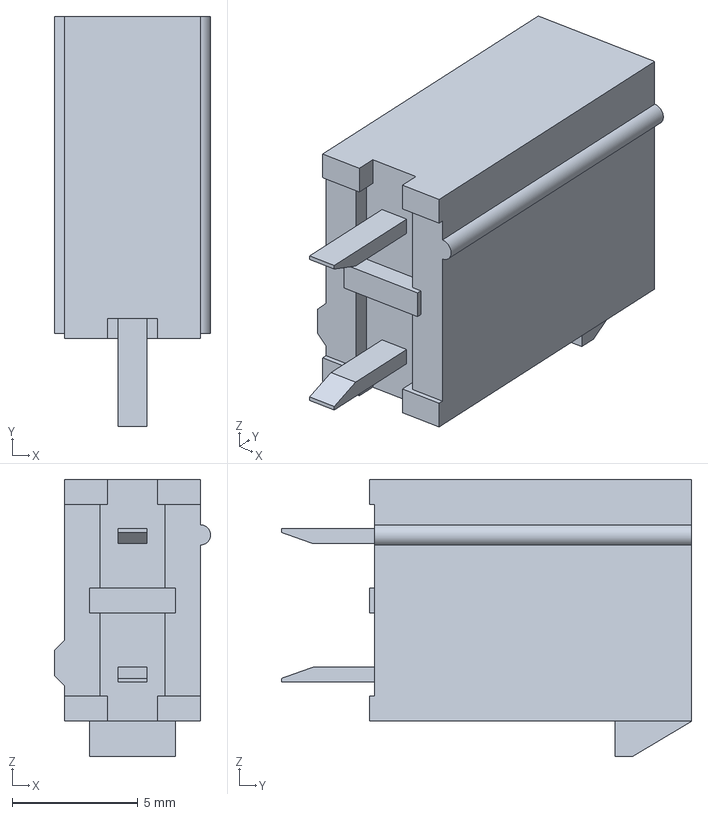
[picture p12: CAD file, 2019-11-18]
3DModels/molex_mini_fit_jr_2x1.stp
6.20 x 16.3 x 11.0 mm
