Lafayette-FSAE/PacMan/3DModels/DF22-2P-7.92DSA.stp

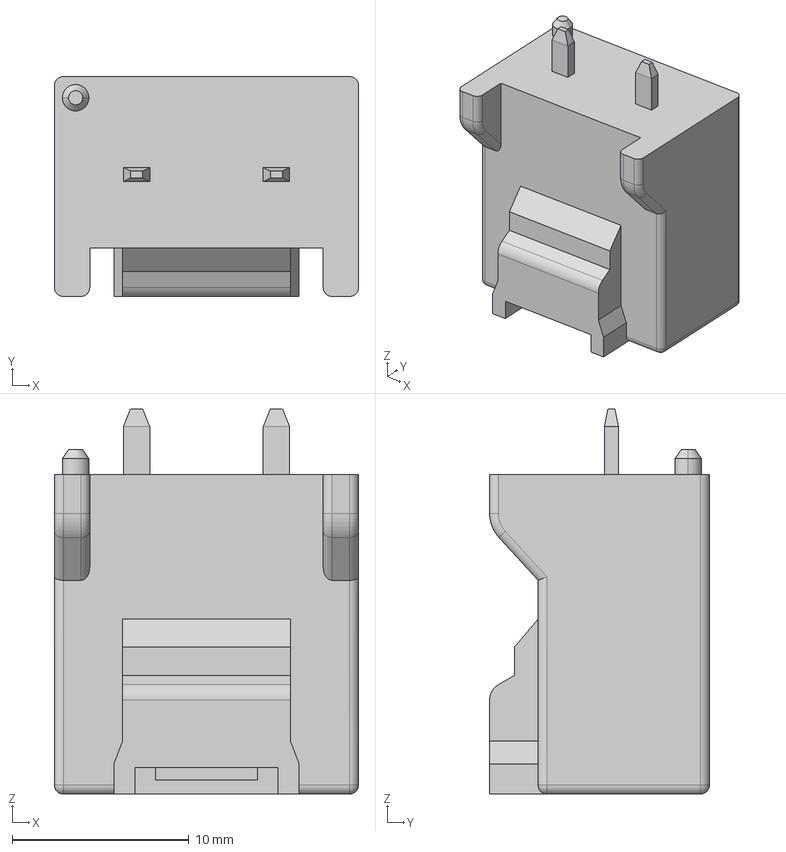
[picture p13: CAD file, 2019-11-15]
3DModels/DF22-2P-7.92DSA.stp
17.2 x 12.4 x 21.8 mm
