Lafayette-FSAE/PacMan/3DModels/CUI_PDQE10-Q24-S9-D.step

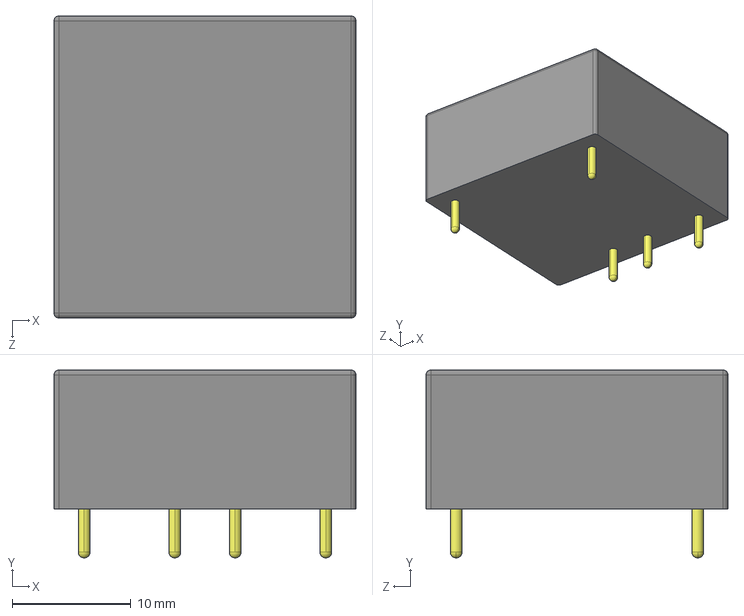
[picture p14: CAD file, 2019-11-15]
3DModels/CUI_PDQE10-Q24-S9-D.step
25.4 x 15.8 x 25.4 mm
