Lafayette-FSAE/PacMan/3DModels/molex_mini_fit_jr_2x2.stp

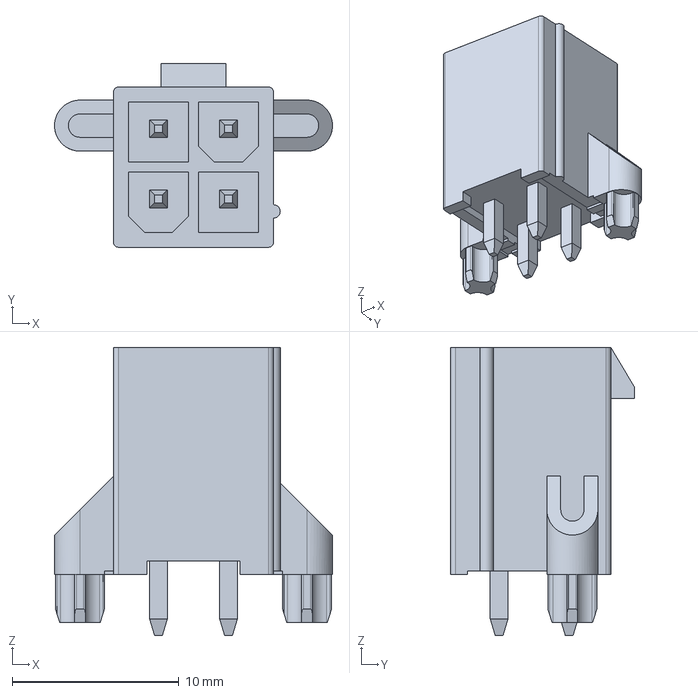
[picture p15: CAD file, 2019-11-15]
3DModels/molex_mini_fit_jr_2x2.stp
16.7 x 11.0 x 17.3 mm
