Lafayette-FSAE/PacMan/3DModels/c-1-1393210-9-j-3d.stp

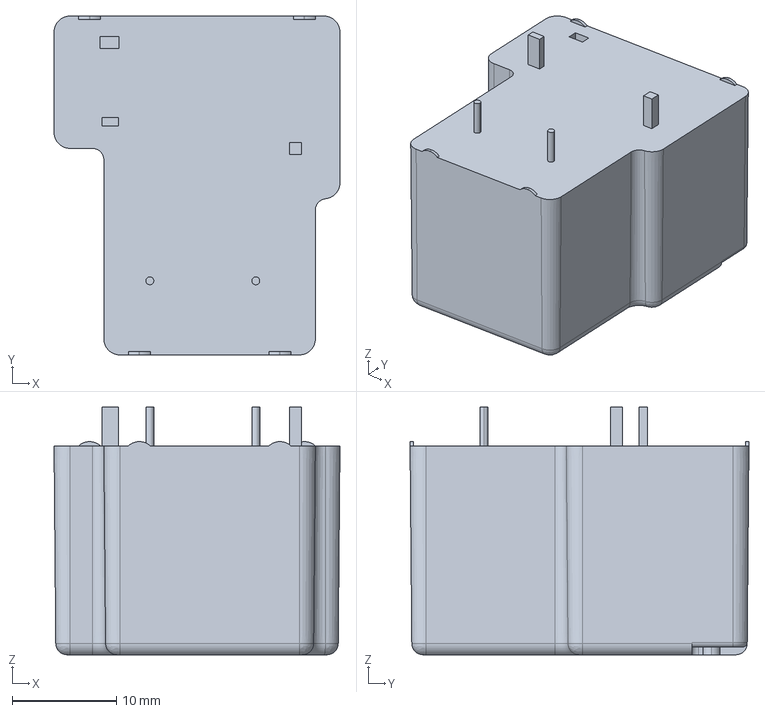
[picture p16: CAD file, 2019-11-15]
3DModels/c-1-1393210-9-j-3d.stp
27.4 x 32.5 x 23.7 mm
