Lafayette-FSAE/PacMan/3DModels/G5Q_1A4.step

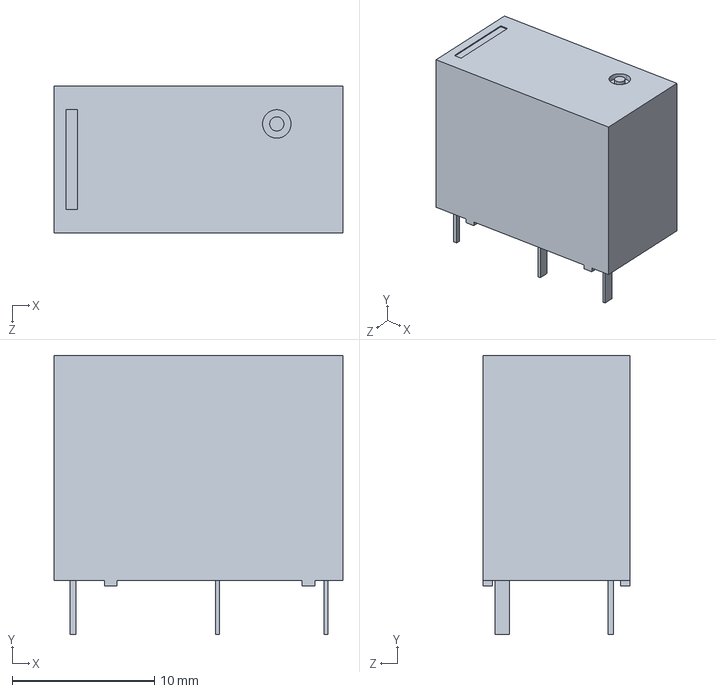
[picture p17: CAD file, 2019-11-15]
3DModels/G5Q_1A4.step
20.3 x 19.6 x 10.3 mm
