Lafayette-FSAE/PacMan/3DModels/molex_mini_fit_jr_2x3.stp

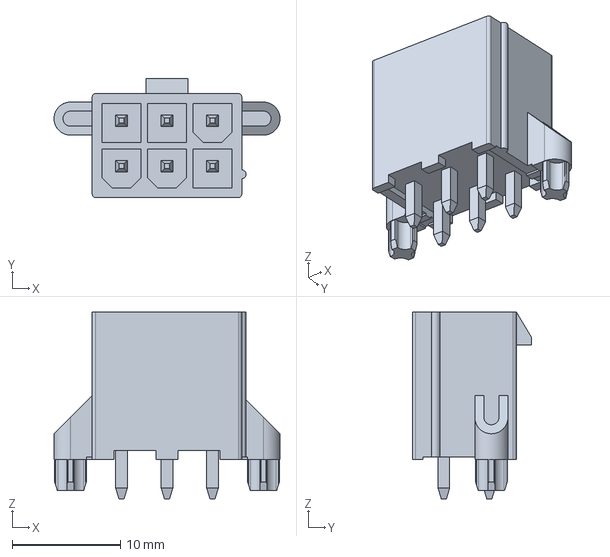
[picture p18: CAD file, 2019-11-15]
3DModels/molex_mini_fit_jr_2x3.stp
20.9 x 11.0 x 17.3 mm
