Lafayette-FSAE/PacMan/3DModels/DF22-1P-7.92DSA.stp

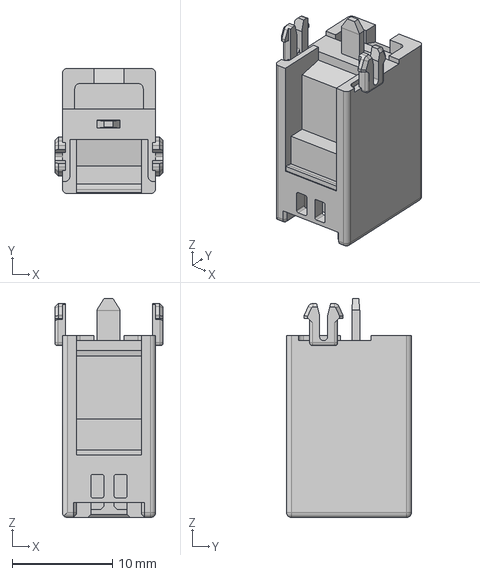
[picture p19: CAD file, 2019-11-15]
3DModels/DF22-1P-7.92DSA.stp
10.8 x 12.4 x 21.8 mm
