Lafayette-FSAE/PacMan/3DModels/CUI_V7805-500.step

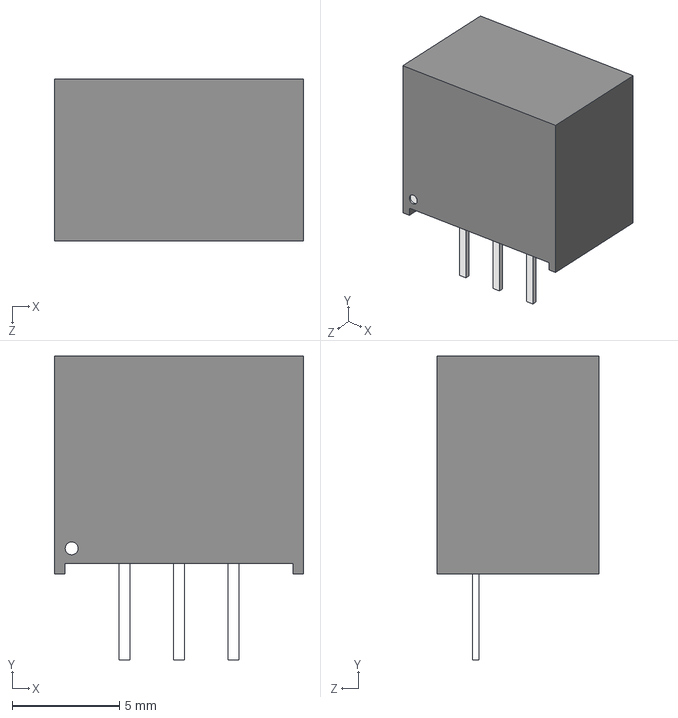
[picture p20: CAD file, 2019-11-08]
3DModels/CUI_V7805-500.step
11.6 x 14.2 x 7.55 mm
