Lafayette-FSAE/PacMan/(list of files, cad)

Other CAD files:
3DModels/tec2(wi).STEP
3DModels/CUI_PDQE10-Q48-S24-D.step
3DModels/39281083.stp
3DModels/39281123.stp
3DModels/75869_y04_asm.stp
