Lafayette-FSAE/PacMan/Documentation/Schematic 0.3.pdf

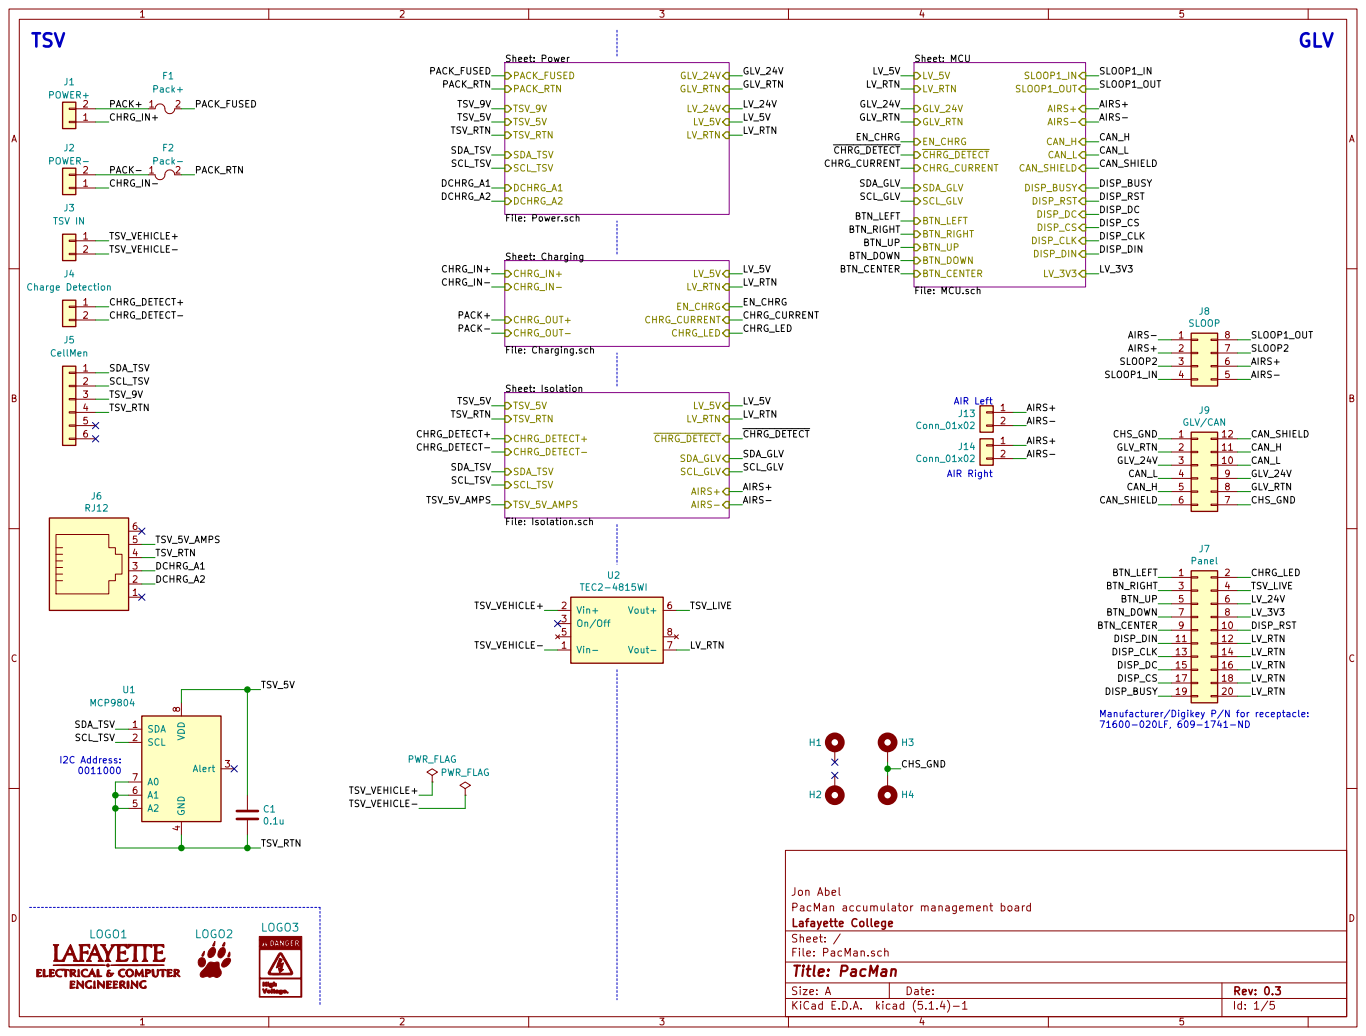
[picture p21: page 1]

Manufacturer/Digikey P/N for receptacle: 71600-020LF, 609-1741-ND TSV
PACK+ SCL_TSV

Jon Abel
PacMan accumulator management board
File: PacMan.sch Sheet: / Lafayette College

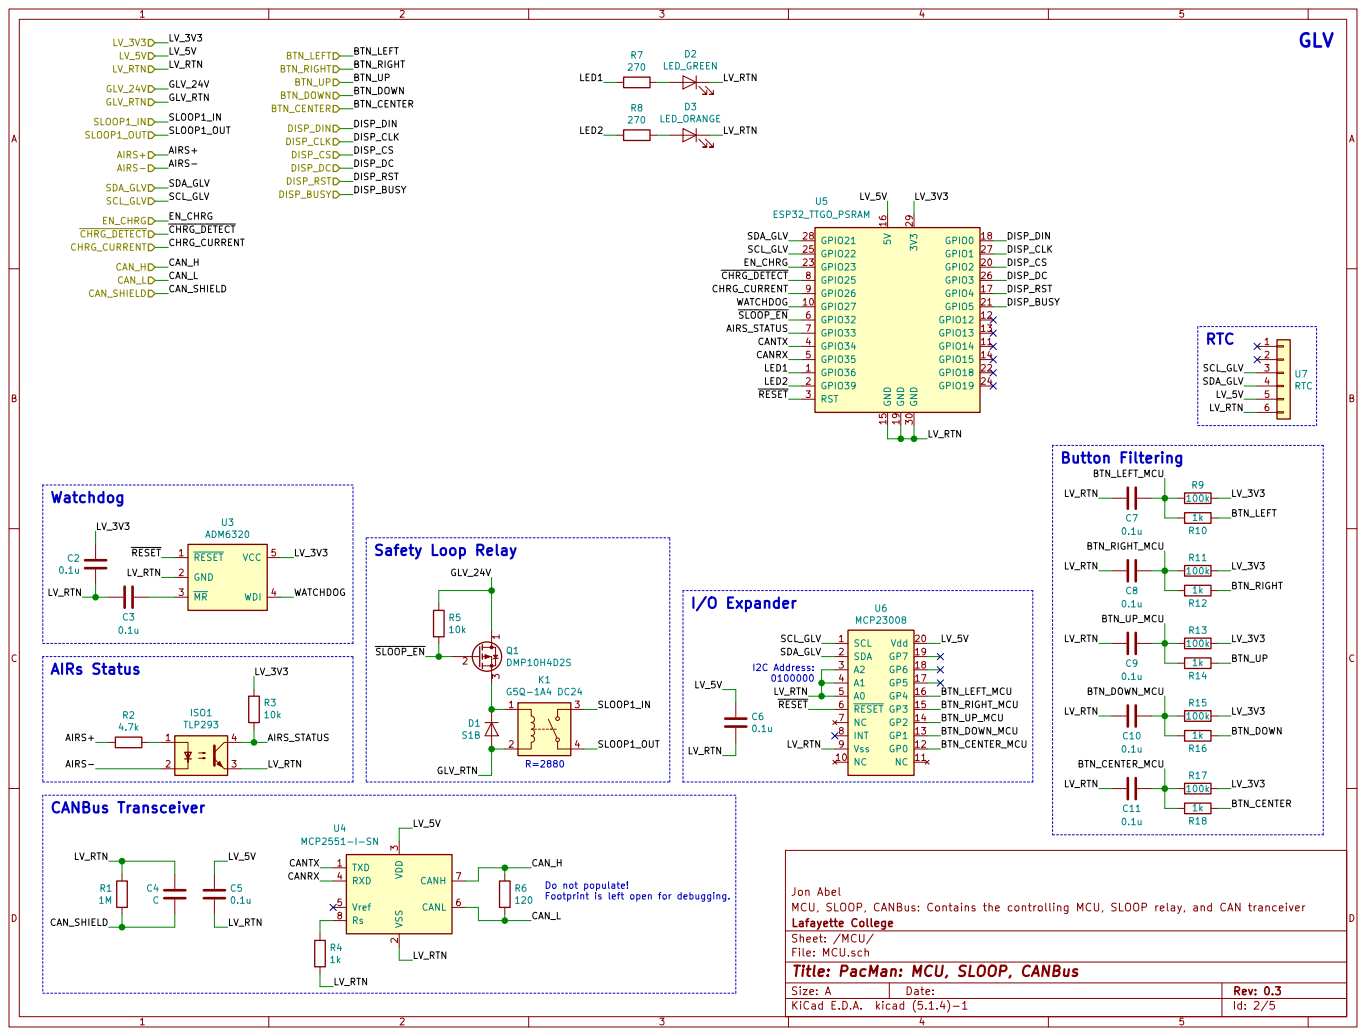
[picture p22: page 2]

3 RXD 4 Vref 5 CANL 6 CANH 7 Rs 8U4 MCP2551-I-SN

Do not populate!
Footprint is left open for debugging.

File: MCU.sch Sheet: /MCU/ Lafayette College

Id: 2/5 Title: PacMan: MCU, SLOOP, CANBus

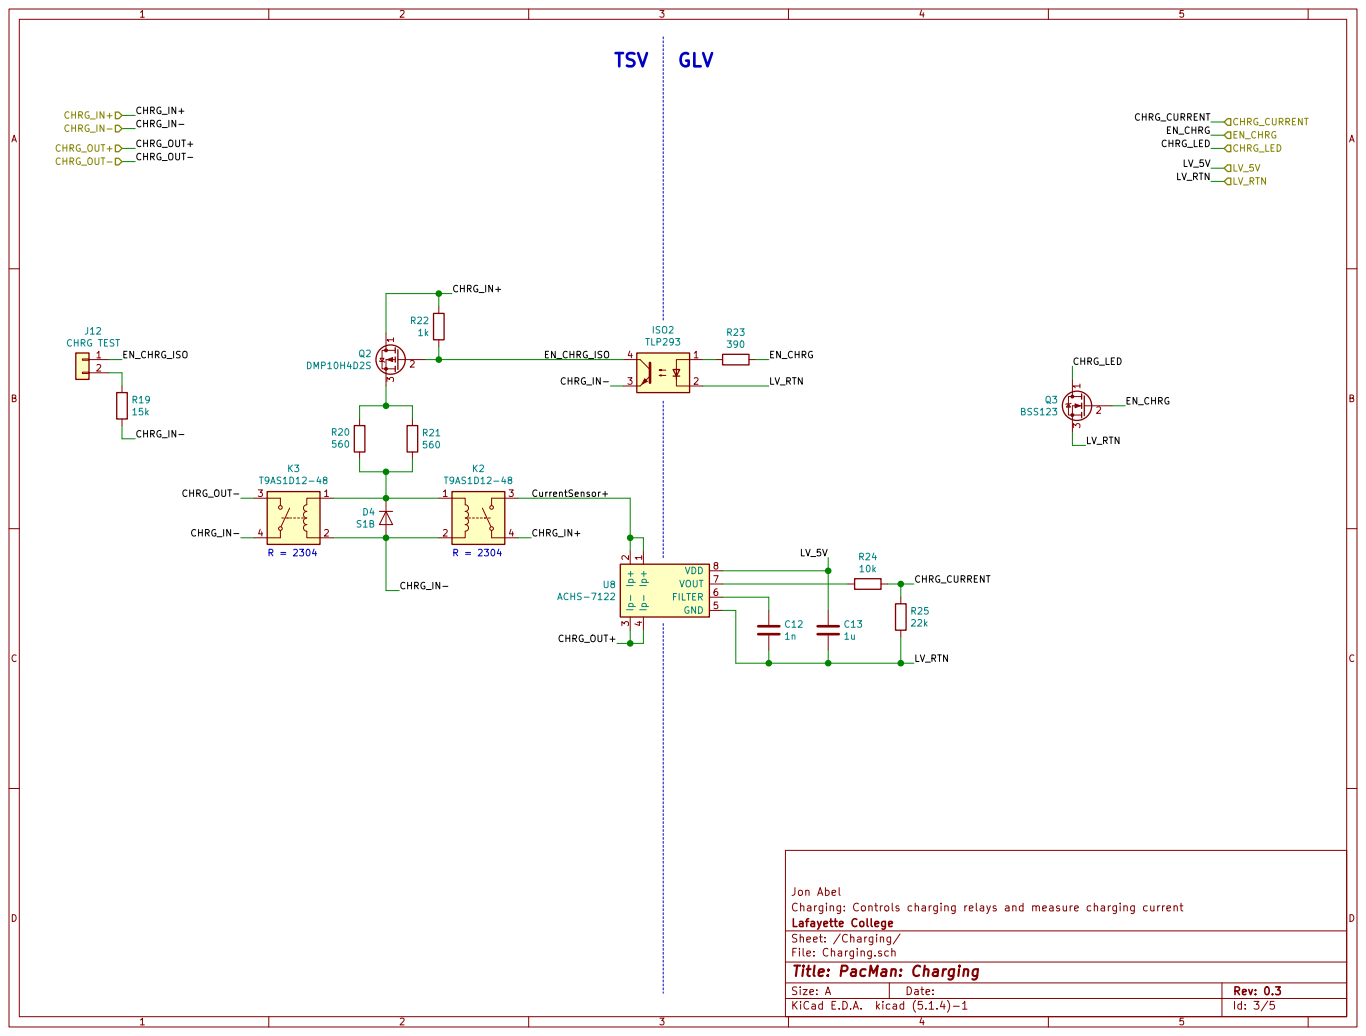
[picture p23: page 3]

2 Ip- 3 Ip- 4 GND 5 FILTER 6 VOUT 7 VDD 8 U8 ACHS-7122

Charging: Controls charging relays and measure charging current Jon Abel

Lafayette College
Sheet: /Charging/
File: Charging.sch
Id: 3/5 Title: PacMan: Charging

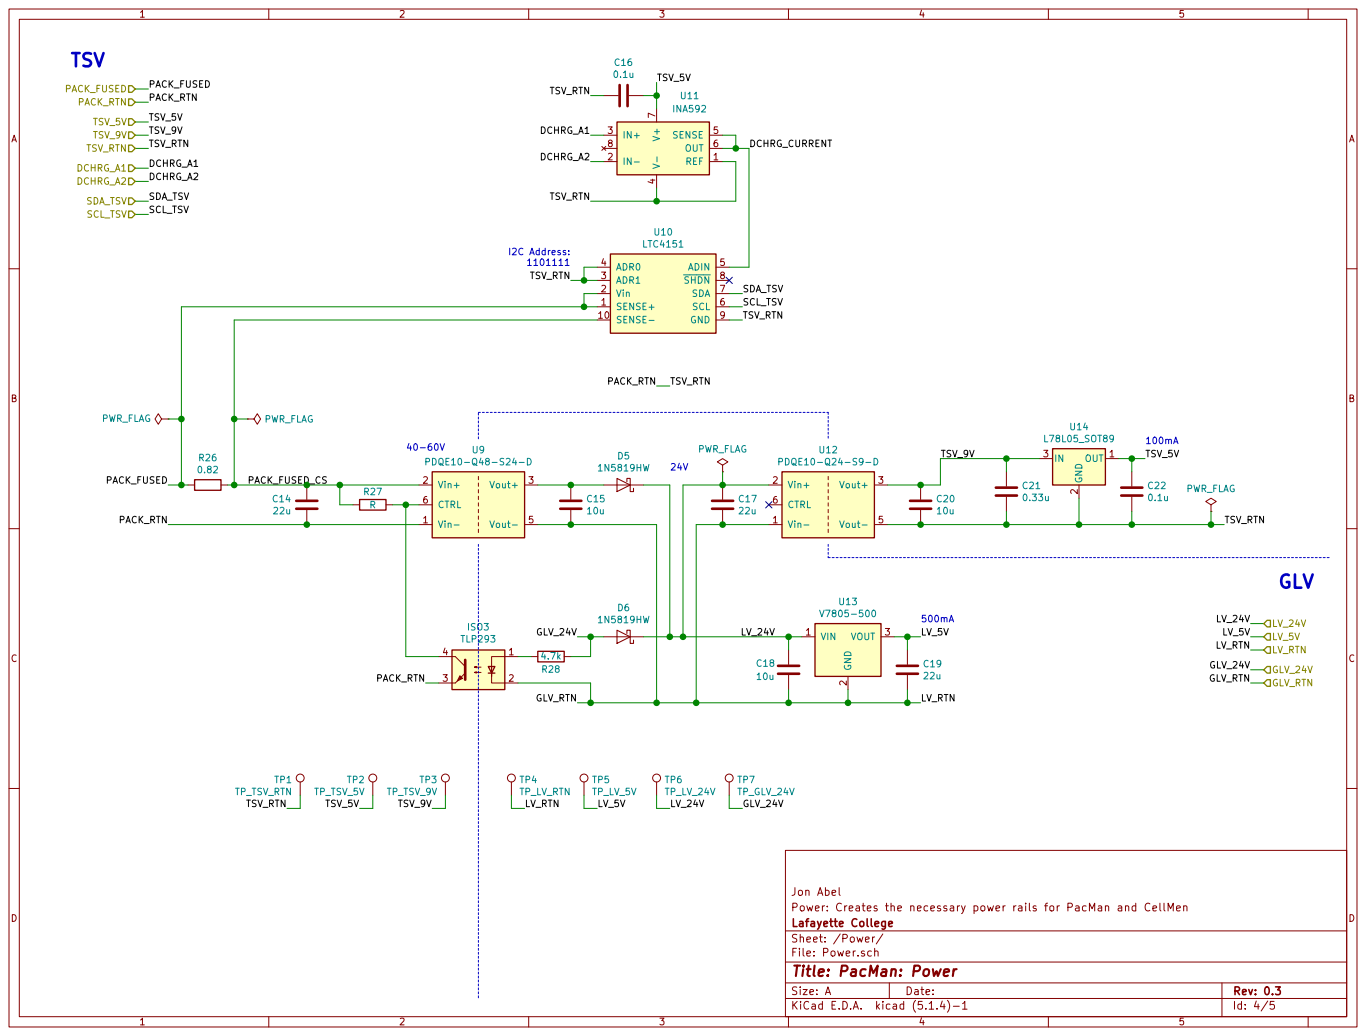
[picture p24: page 4]

Power: Creates the necessary power rails for PacMan and CellMen
Id: 4/5 Title: PacMan: Power File: Power.sch Sheet: /Power/ Lafayette College

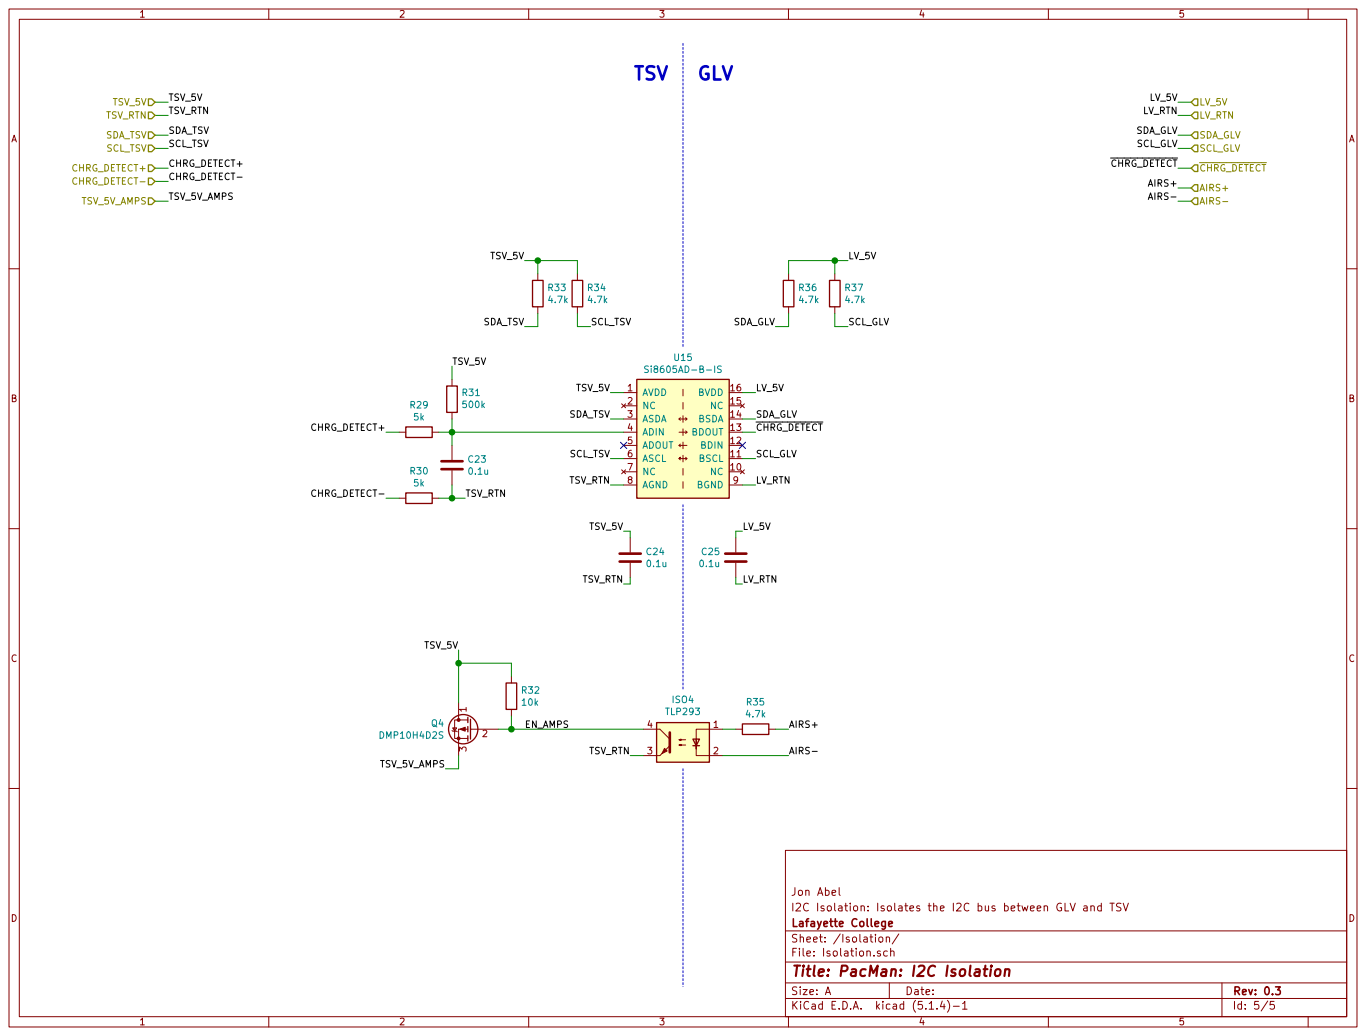
[picture p25: page 5]

I2C Isolation: Isolates the I2C bus between GLV and TSV
File: Isolation.sch Sheet: /Isolation/ Lafayette College

Id: 5/5 Title: PacMan: I2C Isolation
