Lafayette-FSAE/PacMan/Documentation/Schematic 1.0.pdf

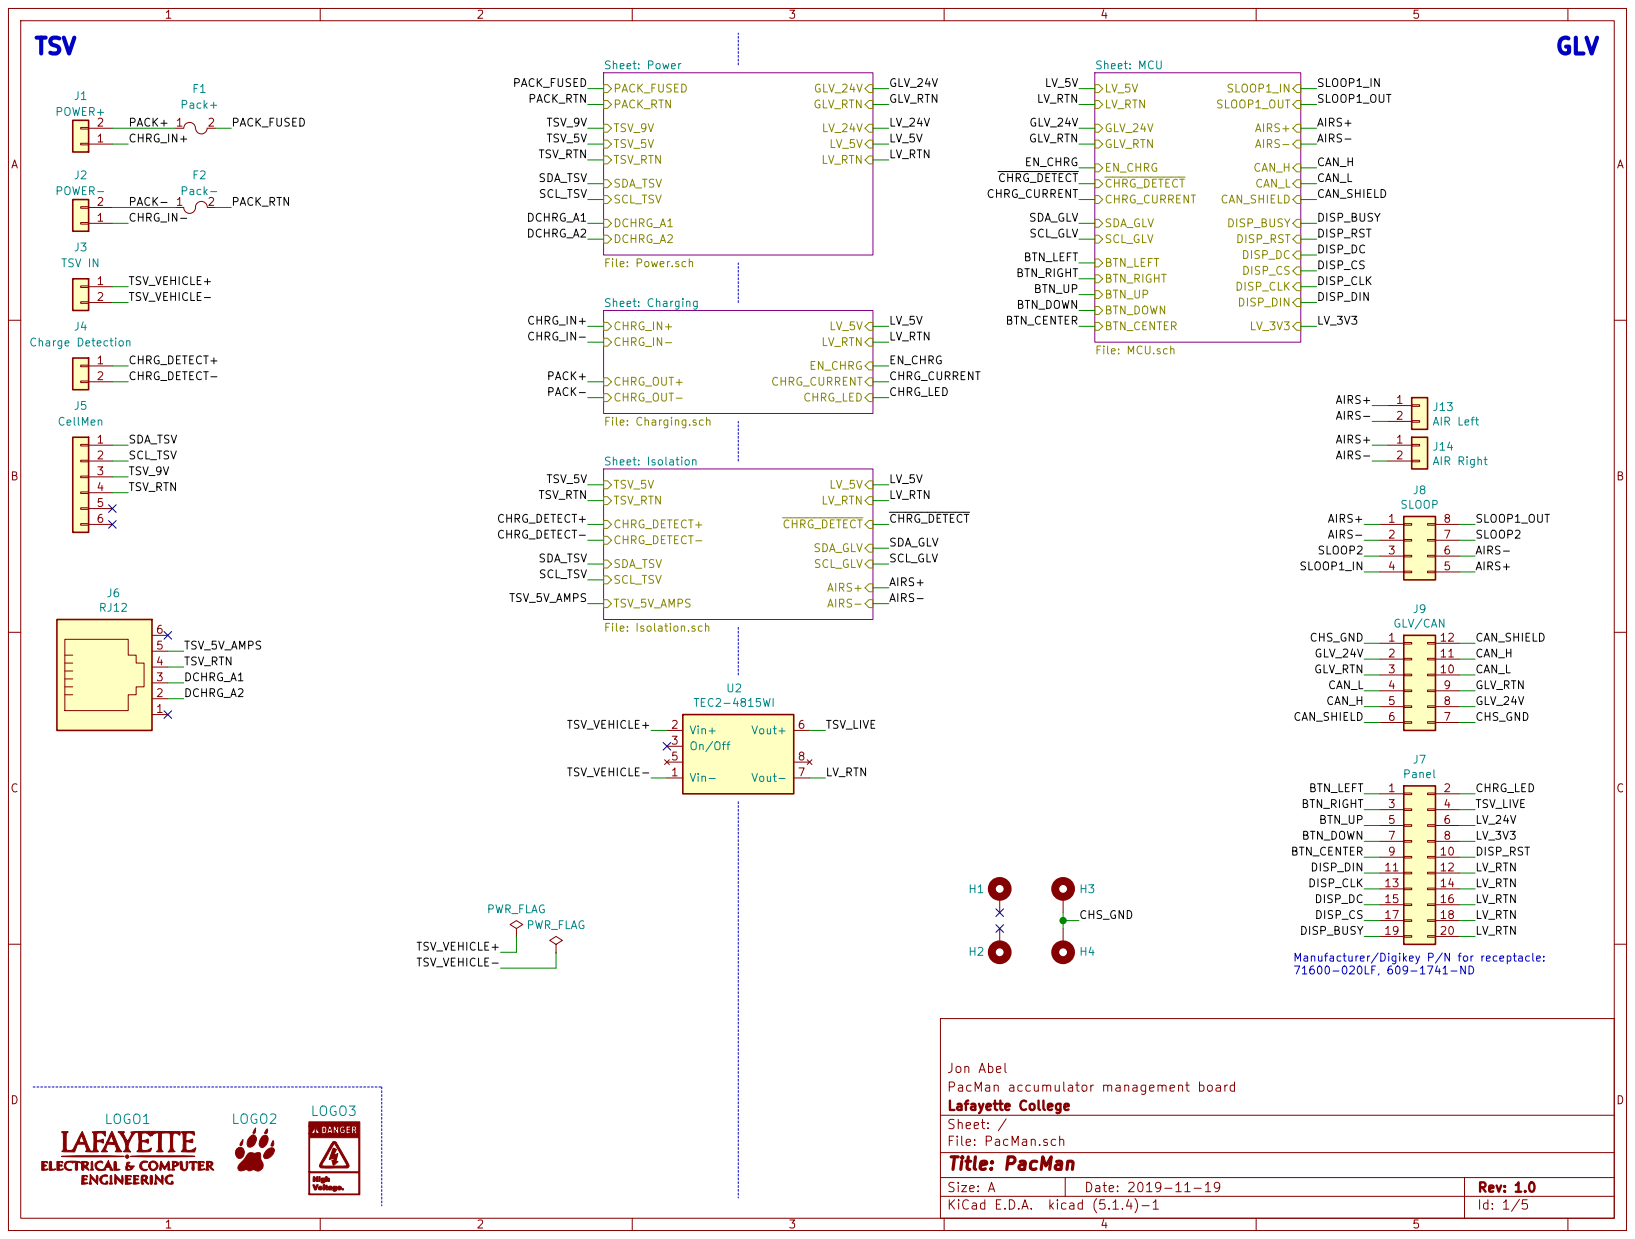
[picture p31: page 1]

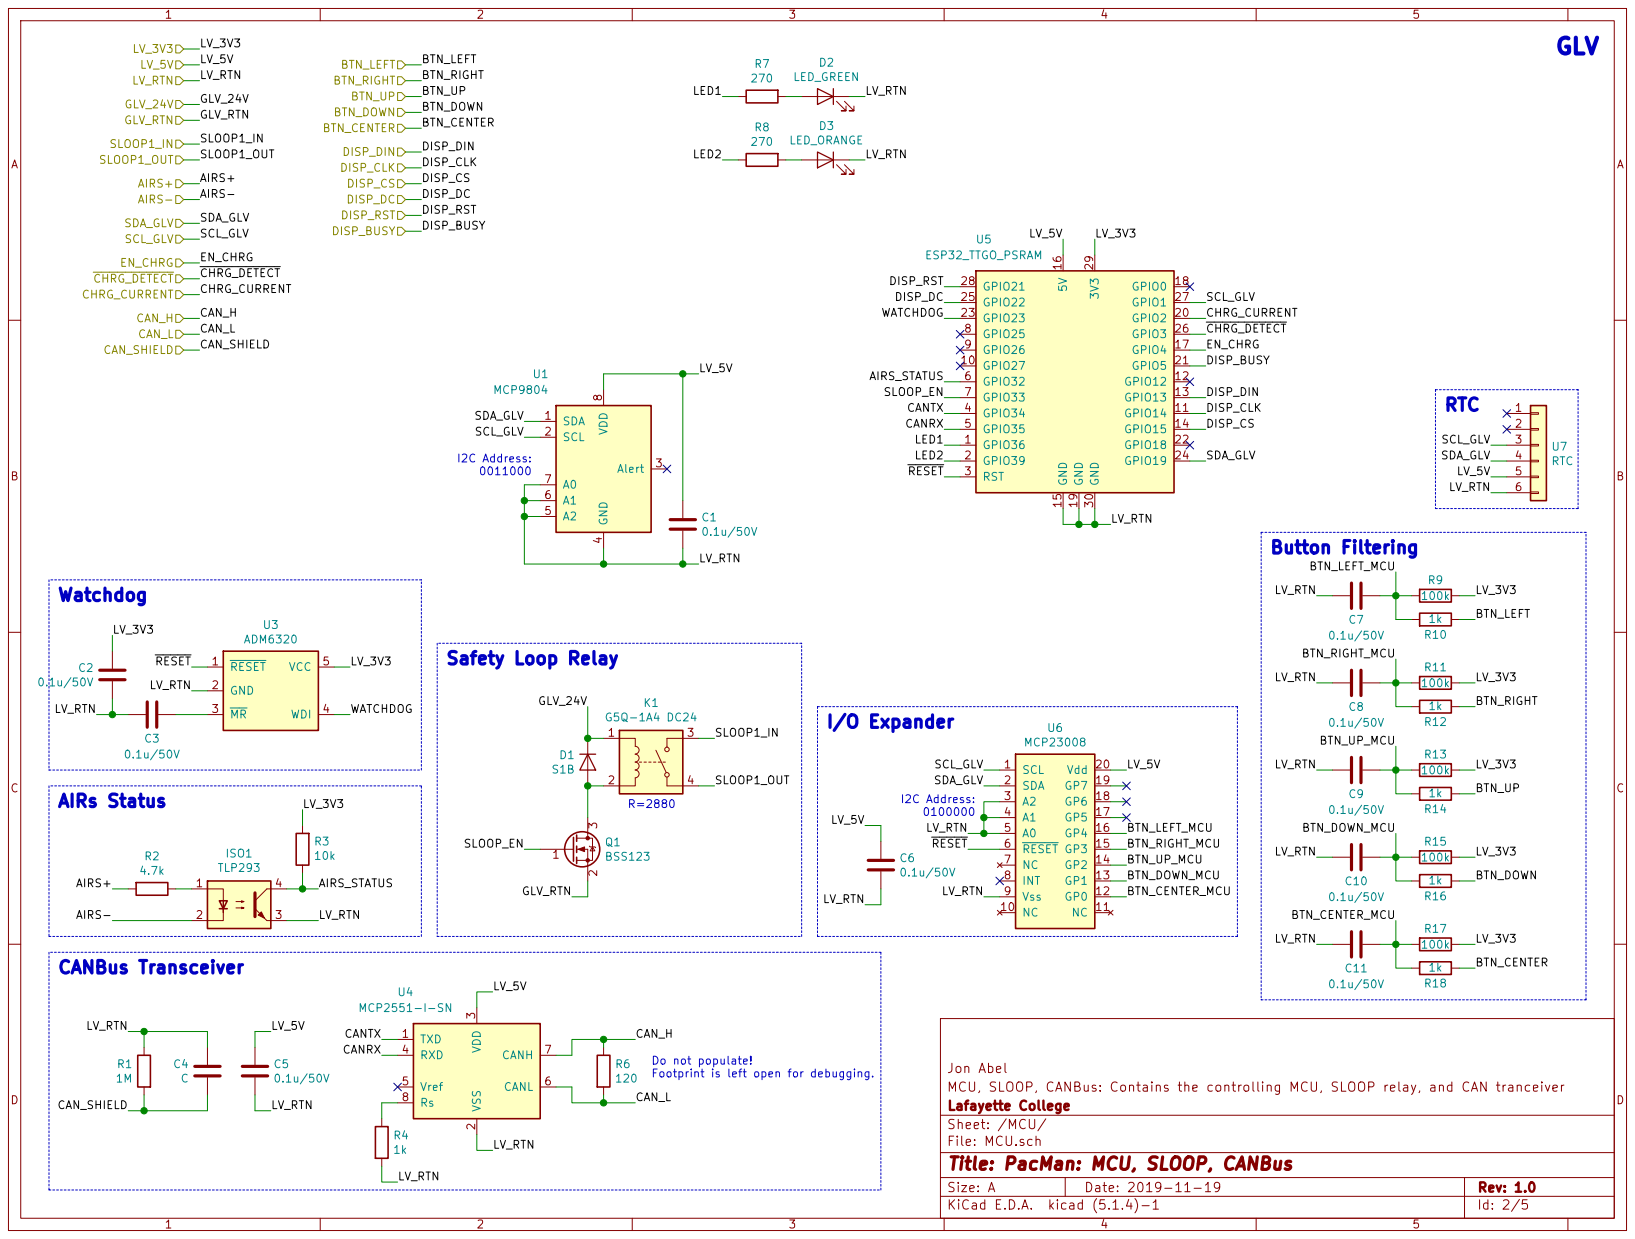
[picture p32: page 2]

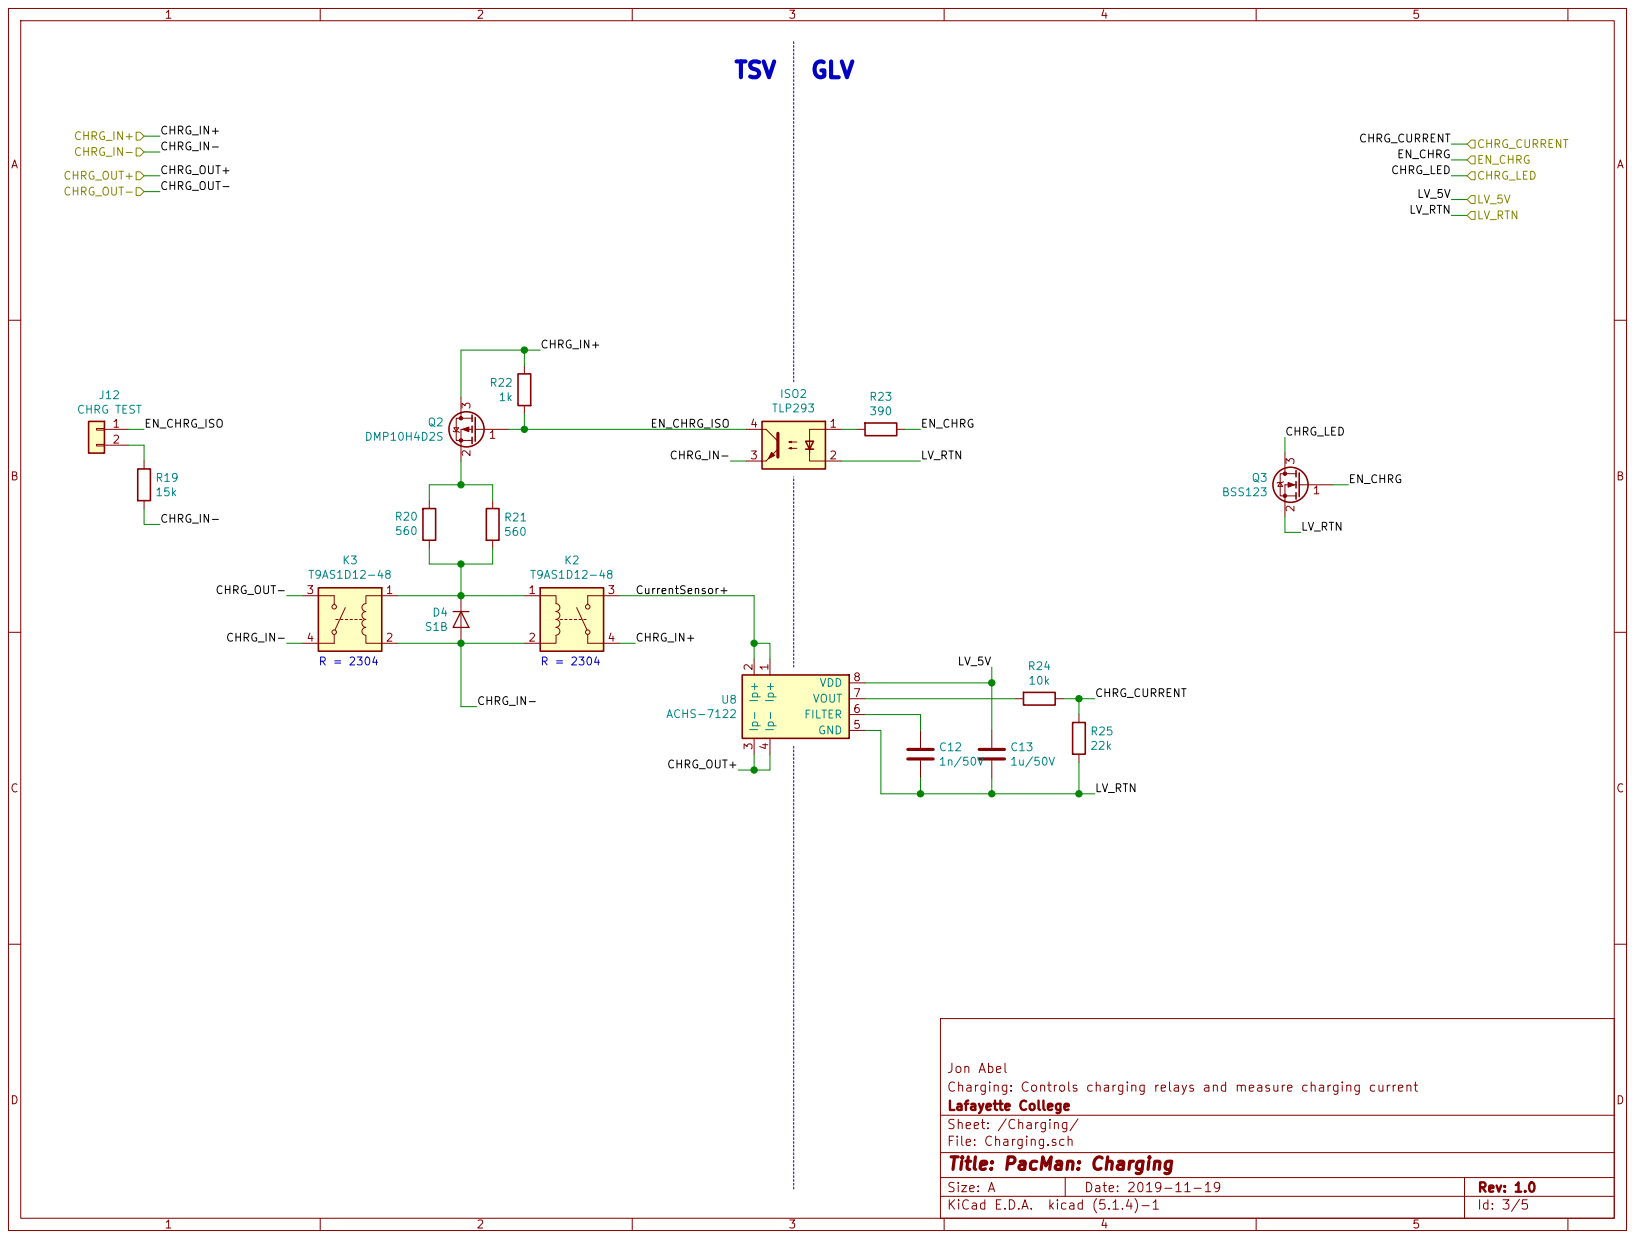
[picture p33: page 3]

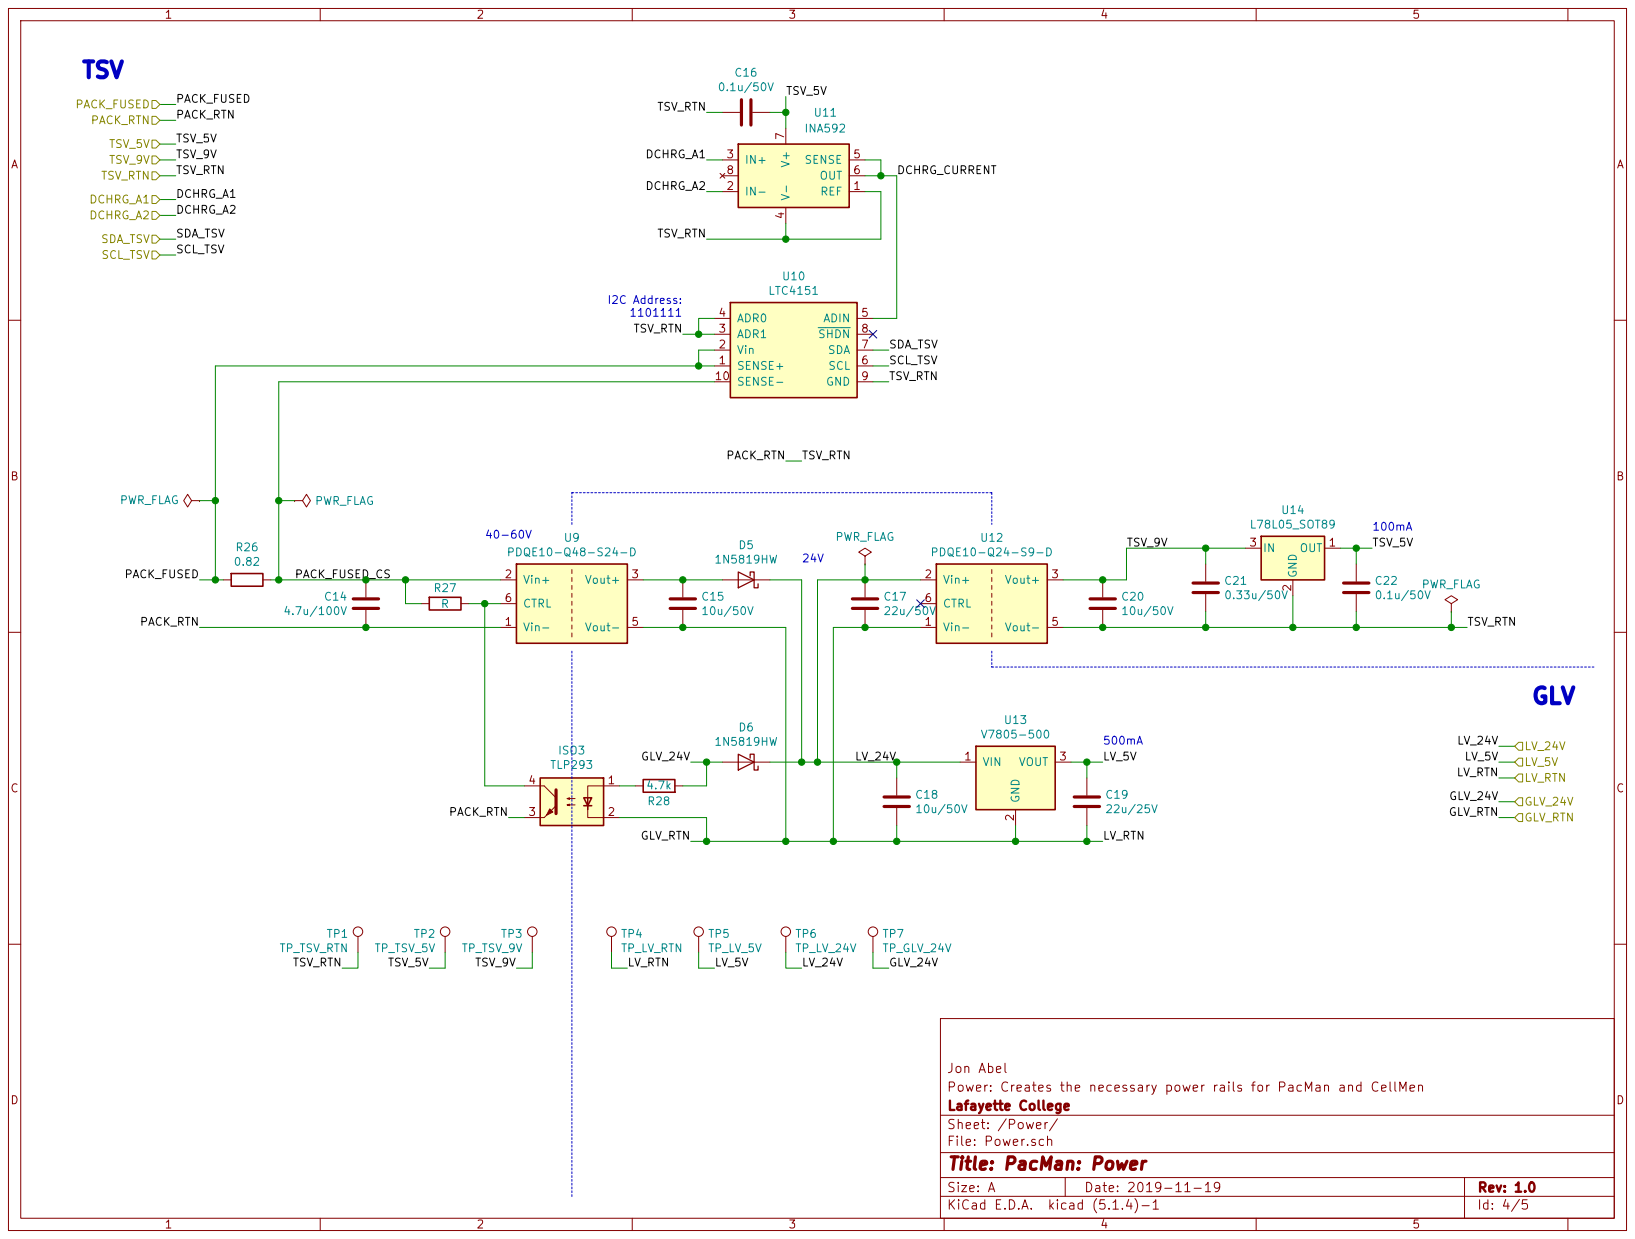
[picture p34: page 4]

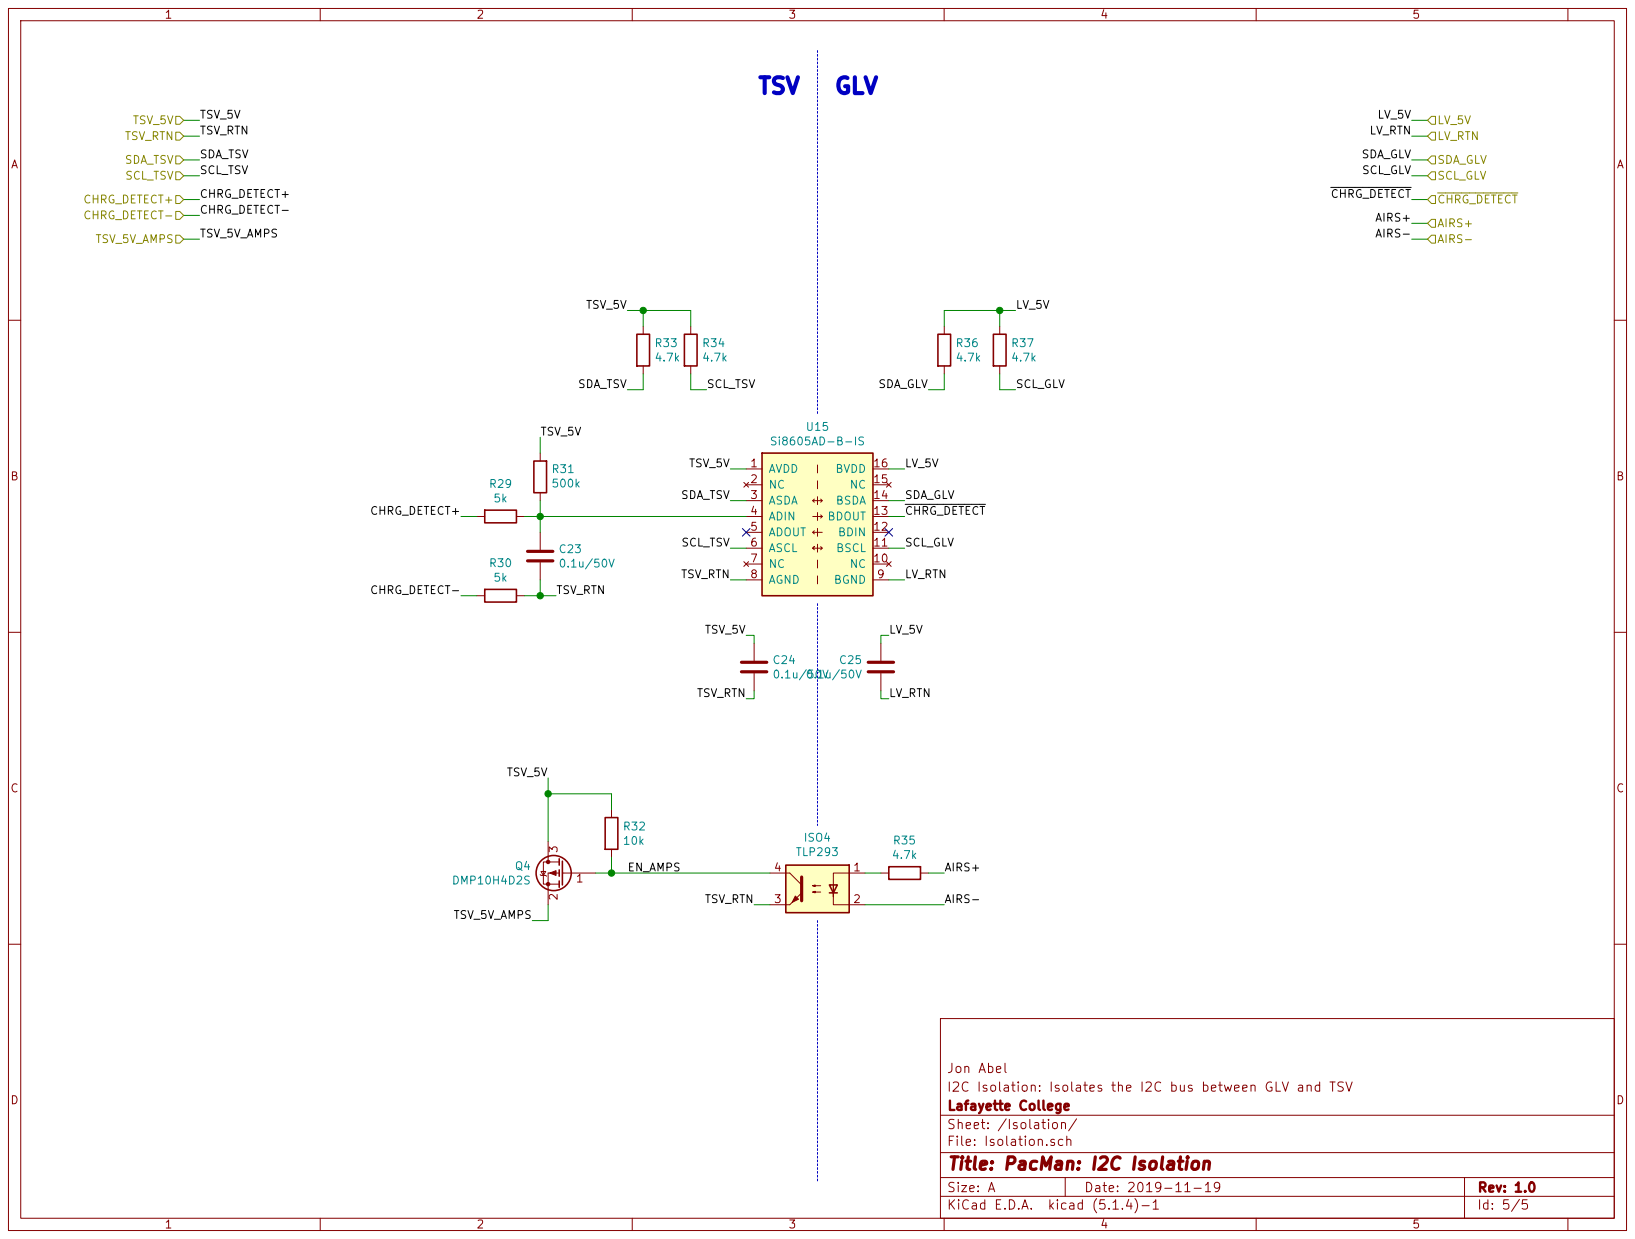
[picture p35: page 5]
