Lafayette-FSAE/PacMan/Documentation/PacMan_v_1_3_Layout.pdf

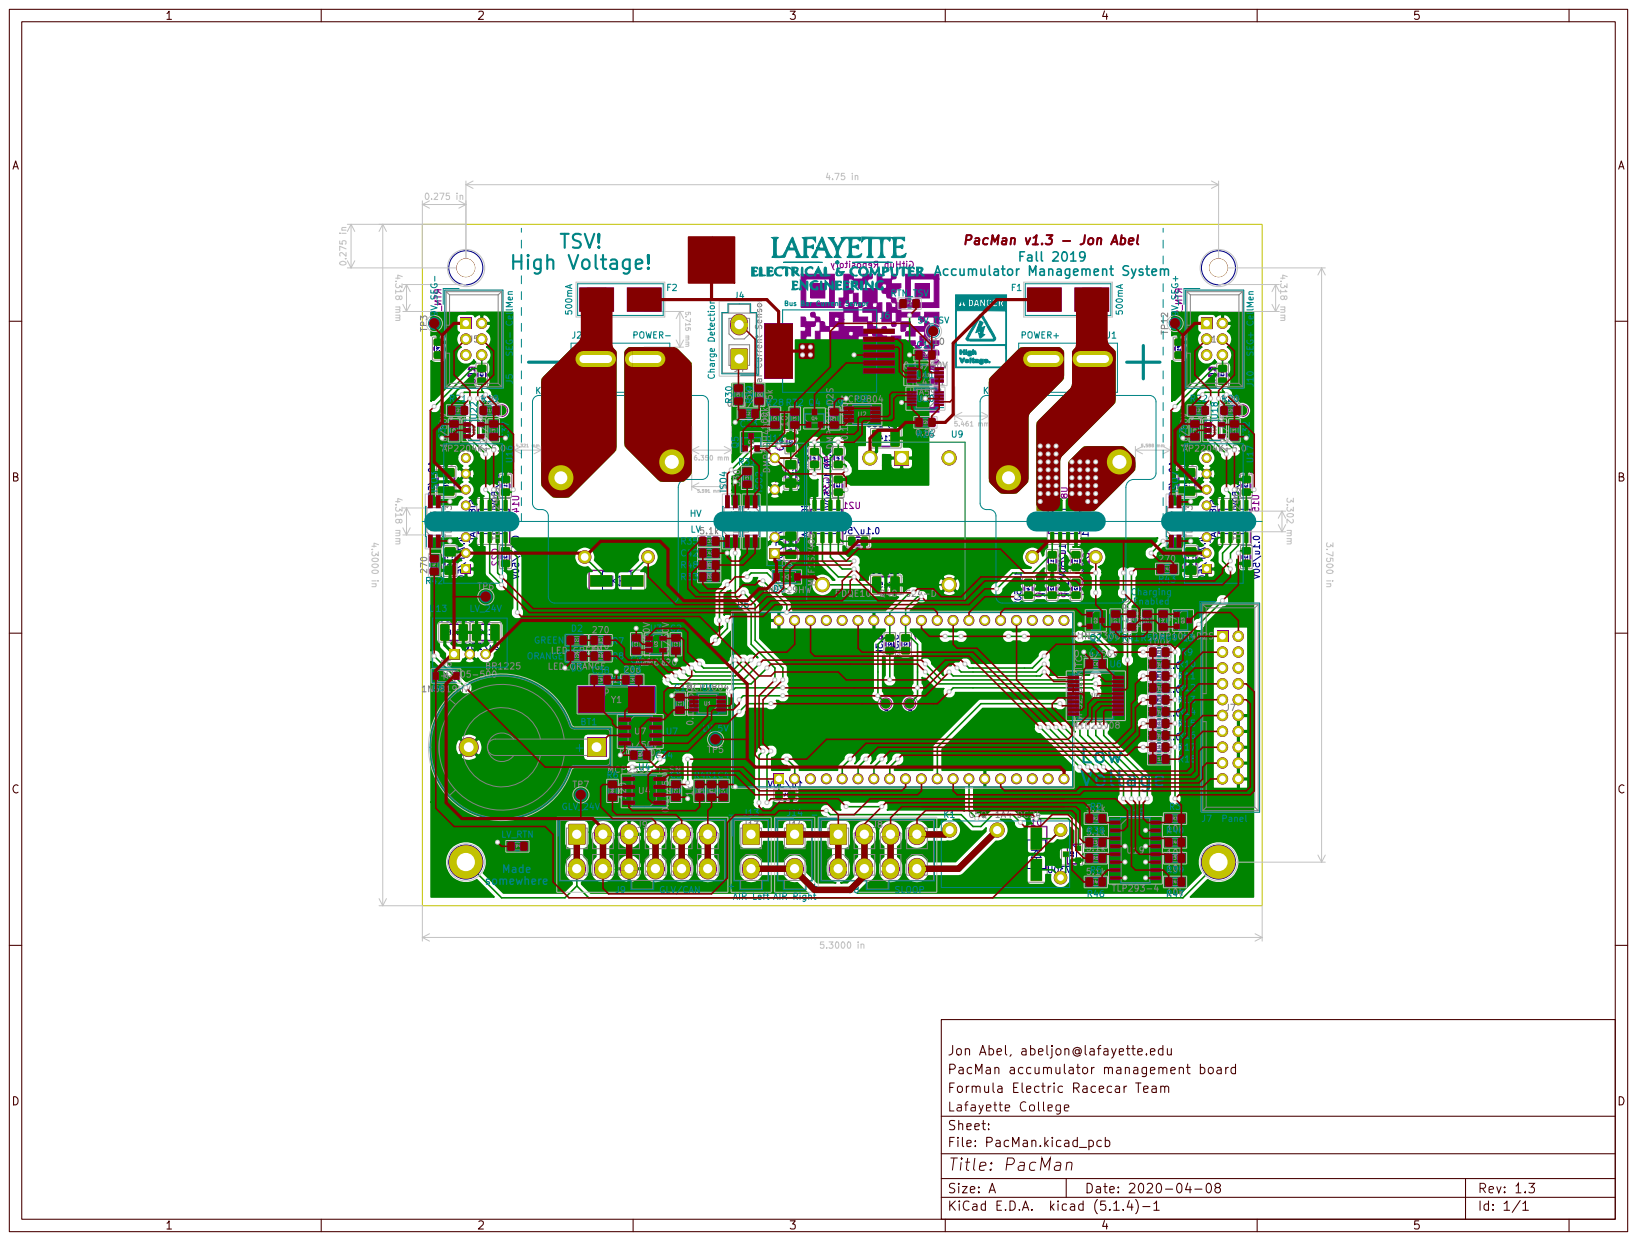
[picture p36: page 1]
