Lafayette-FSAE/PacMan/Documentation/Layout 1.0.pdf

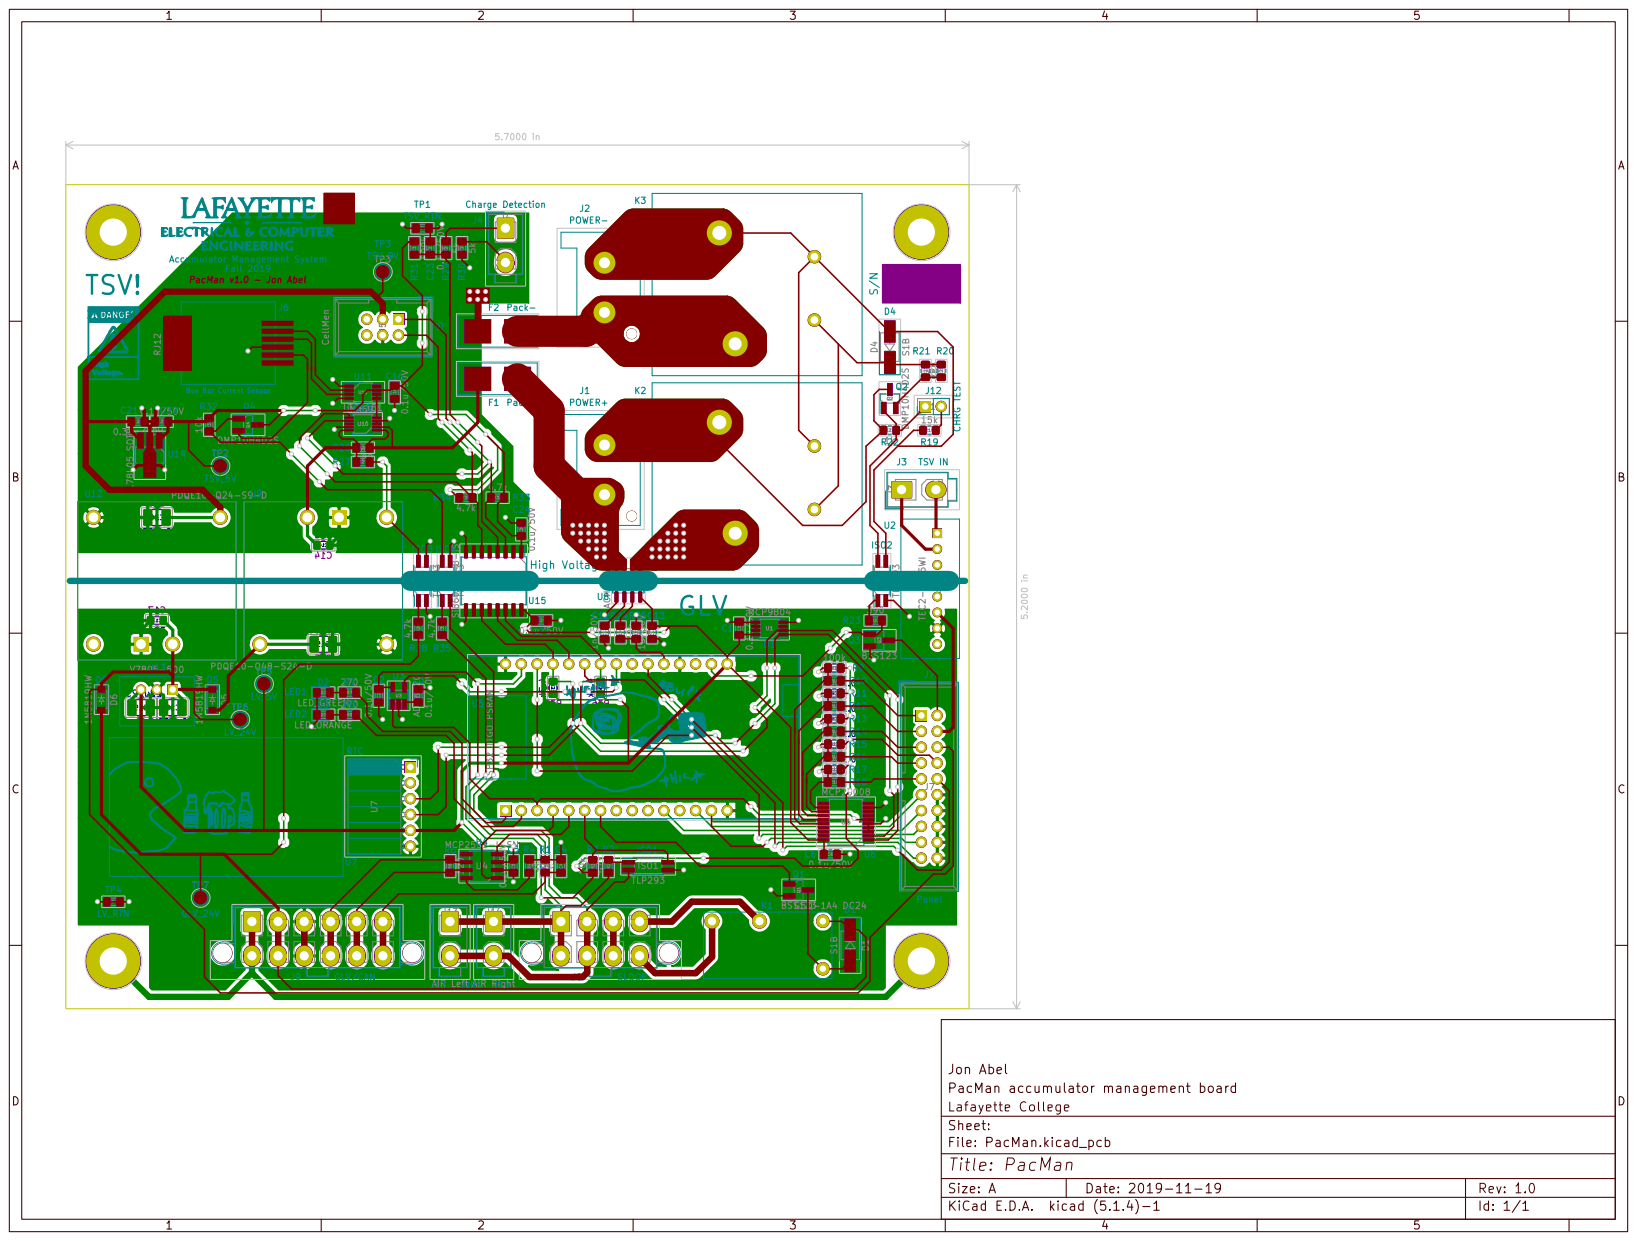
[picture p37: page 1]
