Lafayette-FSAE/PacMan/PacMan.kicad_pcb

## KiCad design PacMan.kicad_pcb (2020-04-14)

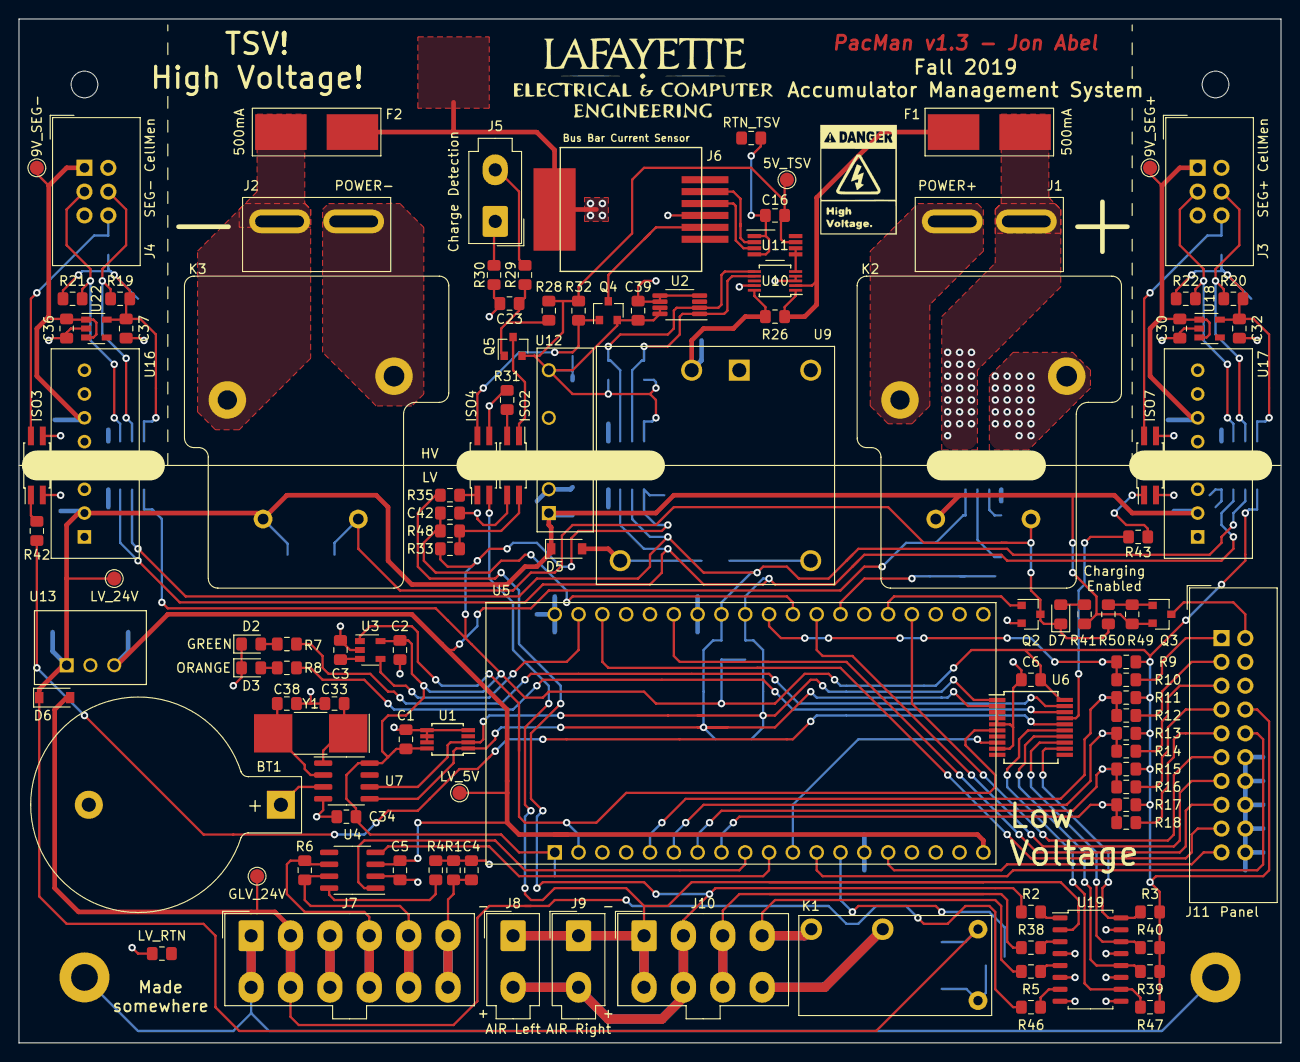
[picture p38: board PacMan.kicad_pcb from above]

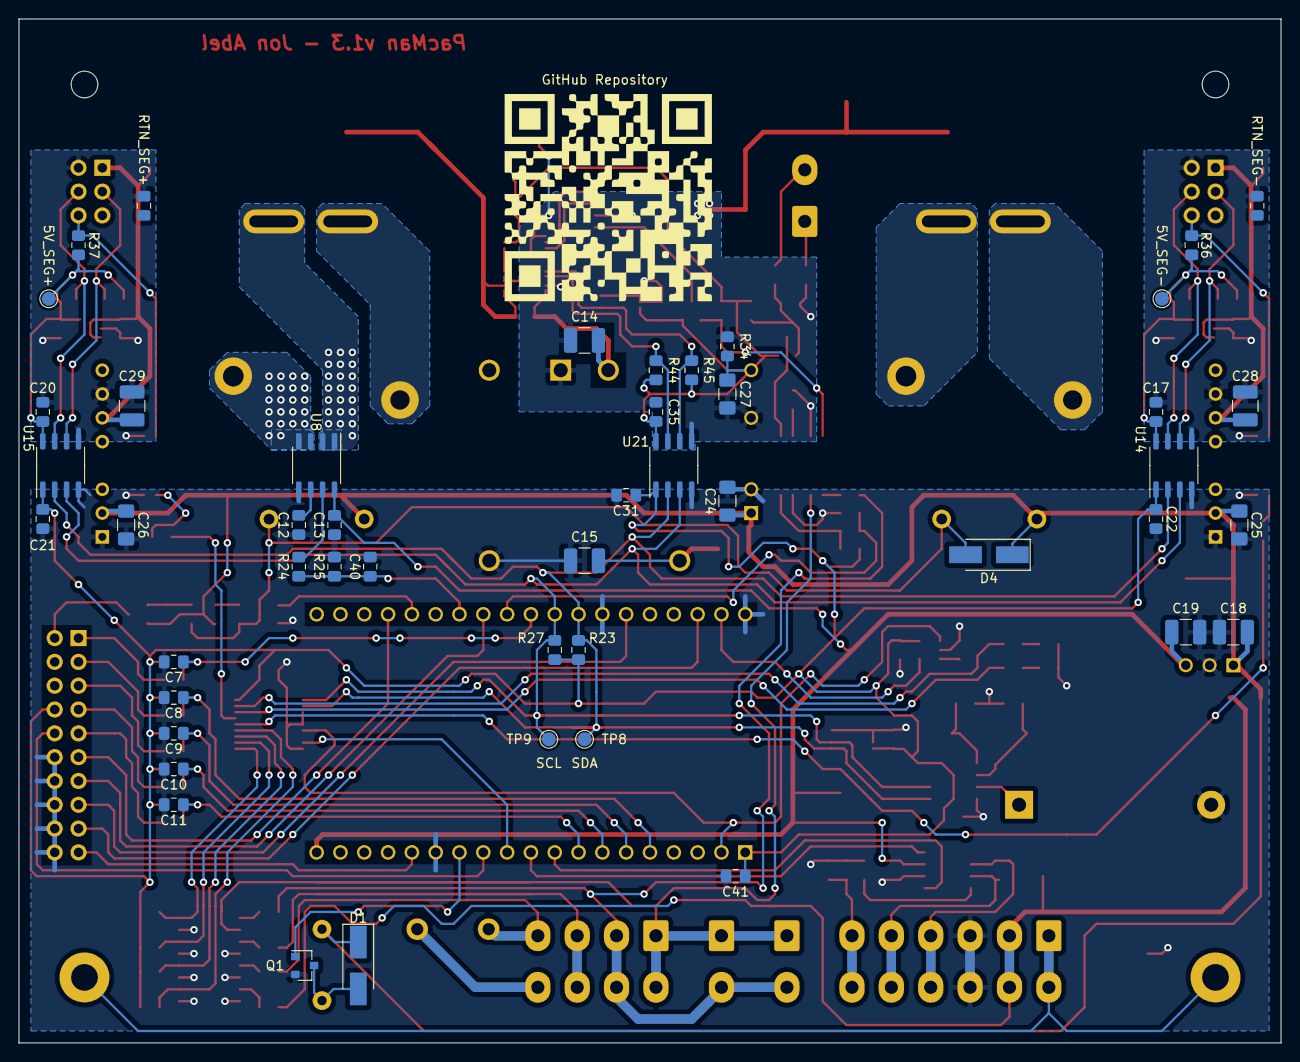
[picture p39: board PacMan.kicad_pcb from below]

Board: 2 copper layers, 134.6 x 109.2 mm, 168 parts (47 on the bottom side), 105 nets.

Parts:
BT1: BR1225; BatteryHolder_Keystone_103_1x20mm
C1, C2, C3, C5, C6, C7, C8, C9, C10, C11, C16, C17, C20, C21, C22, C23, C31, C35, C39: 0.1u/50V; C_0805_2012Metric_Pad1.15x1.40mm_HandSolder
C4, C42: C; C_0805_2012Metric_Pad1.15x1.40mm_HandSolder
C12: 1n/50V; C_0805_2012Metric_Pad1.15x1.40mm_HandSolder
C13, C30, C34, C36, C40, C41: 1u/50V; C_0805_2012Metric_Pad1.15x1.40mm_HandSolder
C14: 4.7u/100V; C_1210_3225Metric_Pad1.42x2.65mm_HandSolder
C15, C18, C28, C29: 10u/50V; C_1210_3225Metric_Pad1.42x2.65mm_HandSolder
C19: 22u/25V; C_1210_3225Metric_Pad1.42x2.65mm_HandSolder
C24, C25, C26, C27: 4.7uF/50V; C_1206_3216Metric_Pad1.42x1.75mm_HandSolder
C32, C37: 2.2u/25V; C_0805_2012Metric_Pad1.15x1.40mm_HandSolder
C33, C38: 20p; C_0805_2012Metric_Pad1.15x1.40mm_HandSolder
D1, D4: S1B; D_SMA_Handsoldering
D2: LED_GREEN; LED_0805_2012Metric_Pad1.15x1.40mm_HandSolder
D3: LED_ORANGE; LED_0805_2012Metric_Pad1.15x1.40mm_HandSolder
D5, D6: 1N5819HW; D_SOD-123
D7: LED_CHRG; LED_0805_2012Metric_Pad1.15x1.40mm_HandSolder
F1, F2: 500mA; 0154.500DRL
H1, H2: MountingHole_NoPad_#4; MountingHole_#4_NoPad
H3, H4: MountingHole_Pad_#4; MountingHole_#4_Pad
ISO2, ISO3, ISO4, ISO7: TLP293; SO-4_4.4x2.3mm_P1.27mm
J1: POWER+; Powerpole_PP45_FP_1x2
J2: POWER-; Powerpole_PP45_FP_1x2
J3: SEG+ CellMen; IDC-Header_2x03_P2.54mm_Vertical
J4: SEG- CellMen; IDC-Header_2x03_P2.54mm_Vertical
J5: Charge Detection; Molex_Mini-Fit_Jr_5566-02A_2x01_P4.20mm_Vertical
J6: BusBar Current Sensor; MOLEX_RJ11
J7: GLV/CAN; Molex_Mini-Fit_Jr_5566-12A_2x06_P4.20mm_Vertical
J8: AIR Left; Molex_Mini-Fit_Jr_5566-02A_2x01_P4.20mm_Vertical
J9: AIR Right; Molex_Mini-Fit_Jr_5566-02A_2x01_P4.20mm_Vertical
J10: SLOOP; Molex_Mini-Fit_Jr_5566-08A_2x04_P4.20mm_Vertical
J11: Panel; Amphenol_IDC-Header_2x10_P2.54mm_Vertical
K1: G5Q-1A4 DC24; G5Q-1A4
K2, K3: T9AS1D12-24; T9AS1D12
LOGO1: LafECEDepLogo; ECE_Logo_Jon
LOGO2: LeopardPawLogo; paw_solder_mask_bigly
LOGO3: DangerHighVoltageLogo; highvoltagesmall
Q1, Q2: DMN3730U; SOT-23
Q3, Q4, Q5: DMP10H4D2S; SOT-23
R1: 1M; R_0805_2012Metric_Pad1.15x1.40mm_HandSolder
R2, R5, R35, R38, R46: 5.1k; R_0805_2012Metric_Pad1.15x1.40mm_HandSolder
R3, R24, R32, R33, R36, R37, R39, R40, R47: 10k; R_0805_2012Metric_Pad1.15x1.40mm_HandSolder
R4, R10, R12, R14, R16, R18, R41: 1k; R_0805_2012Metric_Pad1.15x1.40mm_HandSolder
R6: 120; R_0805_2012Metric_Pad1.15x1.40mm_HandSolder
R7, R8, R42, R43: 270; R_0805_2012Metric_Pad1.15x1.40mm_HandSolder
R9, R11, R13, R15, R17, R28: 100k; R_0805_2012Metric_Pad1.15x1.40mm_HandSolder
R19, R20, R21, R22, R23, R27, R44, R45: 3.3k; R_0805_2012Metric_Pad1.15x1.40mm_HandSolder
R25: 22k; R_0805_2012Metric_Pad1.15x1.40mm_HandSolder
R26: 0.82; R_0805_2012Metric_Pad1.15x1.40mm_HandSolder
R29, R30: 5k; R_0805_2012Metric_Pad1.15x1.40mm_HandSolder
R31: 330; R_0805_2012Metric_Pad1.15x1.40mm_HandSolder
R34: 470; R_0805_2012Metric_Pad1.15x1.40mm_HandSolder
R48: R; R_0805_2012Metric_Pad1.15x1.40mm_HandSolder
R49, R50: 4.7k; R_0805_2012Metric_Pad1.15x1.40mm_HandSolder
TP1: 5V_SEG-; TestPoint_Pad_D1.5mm
TP2: RTN_SEG-; R_0805_2012Metric_Pad1.15x1.40mm_HandSolder
TP3: 9V_SEG-; TestPoint_Pad_D1.5mm
TP4: LV_RTN; R_0805_2012Metric_Pad1.15x1.40mm_HandSolder
TP5: LV_5V; TestPoint_Pad_D1.5mm
TP6: LV_24V; TestPoint_Pad_D1.5mm
TP7: GLV_24V; TestPoint_Pad_D1.5mm
TP8: SDA; TestPoint_Pad_D1.5mm
TP9: SCL; TestPoint_Pad_D1.5mm
TP10: 5V_TSV; TestPoint_Pad_D1.5mm
TP11: RTN_TSV; R_0805_2012Metric_Pad1.15x1.40mm_HandSolder
TP12: 9V_SEG+; TestPoint_Pad_D1.5mm
TP13: 5V_SEG+; TestPoint_Pad_D1.5mm
TP14: RTN_SEG+; R_0805_2012Metric_Pad1.15x1.40mm_HandSolder
U1, U2: MCP9804; MSOP-8_3x3mm_P0.65mm
U3: ADM6320; SOT-23-5
U4: MCP2551-I-SN; SOIC-8_3.9x4.9mm_P1.27mm
U5: ESP32_DEVKITC; MODULE_ESP32-DEVKITC-32D
U6: MCP23008; SSOP-20_5.3x7.2mm_P0.65mm
U7: BQ32002; SOIC-8_3.9x4.9mm_P1.27mm
U8: ACHS-7122; SO-8_3.9x4.9mm_P1.27mm
U9: PDQE10-Q48-S24-D; PDQE10-DIP6
U10: LTC4151; MSOP-10_3x3mm_P0.5mm
U11: INA592; VSSOP-8_3.0x3.0mm_P0.65mm
U12: MEF1S2405SP3C
U13: V7805-500; VX7805-500
U14, U15, U21: Si8600AC; SO-8_3.9x4.9mm_P1.27mm
U16, U17: TEC3-2419
U18, U22: AP2204K-5.0; SOT-23-5
U19: TLP293-4; SOIC-16_4.55x10.3mm_P1.27mm
Y1: 32K; Crystal_SMD_SeikoEpson_MC405-2Pin_9.6x4.1mm

Connections:
/5V_SEG+: C20.1, C32.1, R20.1, R22.1, R37.1, TP13.1, U15.8, U18.5
/5V_SEG-: C17.1, C37.1, R19.1, R21.1, R36.1, TP1.1, U14.8, U22.5
/5V_TSV: C16.2, C27.1, C35.1, C39.1, Q4.2, Q5.2, R28.1, R32.1, R34.1, R44.1, R45.1, TP10.1, U2.7, U2.8, U11.7, U12.7, U21.8
/9V_SEG+: C29.1, C30.1, J3.1, TP12.1, U17.6, U18.1, U18.3
/9V_SEG-: C28.1, C36.1, J4.1, TP3.1, U16.6, U22.1, U22.3
/AIRS+: J8.2, J9.2, J10.2, J10.6, R2.2, R35.2
/AIRS-: ISO4.2, J8.1, J9.1, J10.1, J10.5, U19.2
/AMPS_PWR: J6.5, Q4.3
/BTN_CENTER: J11.9, R18.1
/BTN_DOWN: J11.7, R16.1
/BTN_LEFT: J11.1, R10.1
/BTN_RIGHT: J11.3, R12.1
/BTN_UP: J11.5, R14.1
/CAN_H: J7.5, J7.11, R6.1, U4.7
/CAN_L: J7.4, J7.10, R6.2, U4.6
/CAN_SHIELD: C4.2, J7.6, J7.12, R1.2
/CHRG_CURRENT: C40.1, R24.1, R25.1, U5.32
/CHRG_DETECT+: J5.2, R29.2
/CHRG_DETECT-: J5.1, R30.2
/CHRG_EN: Q2.1, U5.34
/CHRG_IN+: J1.2, K2.3
/CHRG_IN-: J2.1, K3.4
/CHRG_LED: J11.2, Q3.3
/CHS_GND: H3.1, H4.1, J7.1, J7.7
/Charging/CurrentSensor+: K2.4, U8.3, U8.4
/DCHRG_A1: J6.3, U11.3
/DCHRG_A2: J6.2, U11.2
/DISP_BUSY: J11.13, U5.31
/DISP_CLK: J11.10, U5.12
/DISP_CS: J11.11, U5.35
/DISP_DC: J11.17, U5.22
/DISP_DIN: J11.19, U5.15
/DISP_RST: J11.15, U5.25
/GLV_24V: D6.2, J7.2, J7.8, R46.2, TP7.1
/GLV_RTN: BT1.2, C1.2, C2.2, C3.2, C4.1, C5.2, C6.2, C7.2, C8.2, C9.2, C10.2, C11.2, C12.2, C13.2, C15.2, C18.2, C19.2, C21.2, C22.2, C24.2, C25.2, C26.2, C31.2, C33.2, C34.2, C38.2, C40.2, C41.2, C42.2, D2.1, D3.1, ISO2.3, ISO3.2, ISO7.2, J7.3, J7.9, J11.12, J11.14, J11.16, J11.18, J11.20, Q1.2, Q2.2, R1.1, R4.1, R25.2, TP4.1, U1.4, U1.5, U1.6, U1.7, U3.2, U4.2, U5.14, U5.20, U5.26, U6.3, U6.4, U6.5, U6.9, U7.4, U8.5, U9.5, U12.2, U13.2, U14.4, U15.4, U16.1, U17.1, U19.4, U19.6, U19.8, U19.9, U19.11, U19.13, U19.15, U21.4
/Isolation/EN_AMPS: ISO4.4, Q4.1, R32.2
/LV_3V3: C1.1, C2.1, C6.1, C21.1, C22.1, C31.1, C34.1, C41.1, J11.8, R3.2, R9.1, R11.1, R13.1, R15.1, R17.1, R23.1, R27.1, R33.2, R39.2, R40.2, R47.2, U1.8, U3.5, U5.1, U6.20, U7.8, U14.1, U15.1, U21.1
/LV_5V: C5.1, C13.1, C19.1, TP5.1, U4.3, U5.19, U8.8, U13.3
/LV_24V: C18.1, C24.1, C25.1, C26.1, D1.1, D4.1, D5.1, D6.1, K1.1, K2.1, K3.1, Q3.2, R41.1, R49.1, TP6.1, U12.1, U13.1, U16.2, U17.2
/MCU/AIRS_STATUS: R3.1, U6.12, U19.16
/MCU/BTN_CENTER_MCU: C11.1, R17.2, R18.2, U5.8
/MCU/BTN_DOWN_MCU: C10.1, R15.2, R16.2, U5.7
/MCU/BTN_LEFT_MCU: C7.1, R9.2, R10.2, U5.29
/MCU/BTN_RIGHT_MCU: C8.1, R11.2, R12.2, U5.5
/MCU/BTN_UP_MCU: C9.1, R13.2, R14.2, U5.6
/MCU/CANRX: U4.4, U5.10
/MCU/CANTX: U4.1, U5.9
/MCU/GLV_STATUS: R47.1, U6.15, U19.10
/MCU/IO_INT: U5.11, U6.8
/MCU/LED_G: R7.1, U6.19
/MCU/LED_O: R8.1, U6.18
/MCU/SLOOP1_STATUS: R39.1, U6.14, U19.12
/MCU/SLOOP2_STATUS: R40.1, U6.13, U19.14
/MCU/SLOOP_EN: Q1.1, U5.13
/MCU/WATCHDOG: U3.4, U5.21
/MCU/~RESET: U3.1, U5.2, U6.6
/PACK+: F1.1, J1.1, U8.1, U8.2
/PACK-: F2.1, J2.2, K3.3
/PACK_FUSED: F1.2, R26.2, U10.1, U10.2
/PACK_RTN: C14.2, C16.1, C23.2, C27.2, C35.2, C39.2, F2.2, ISO4.3, J6.4, J6.SH, R30.1, R31.1, R34.2, TP11.1, U2.4, U2.5, U2.6, U9.1, U10.3, U10.4, U10.9, U11.1, U11.4, U12.5, U21.5
/Power/DCHRG_CURRENT: U10.5, U11.5, U11.6
/Power/PACK_FUSED_CS: C14.1, R26.1, U9.2, U10.10
/RST_GLV_SEG+: R43.2, U6.17
/RST_GLV_SEG-: R42.2, U6.16
/RST_SEG+: ISO7.4, J3.6, R37.2
/RST_SEG-: ISO3.4, J4.6, R36.2
/RTN_SEG+: C20.2, C29.2, C30.2, C32.2, ISO7.3, J3.2, TP14.1, U15.5, U17.7, U18.2
/RTN_SEG-: C17.2, C28.2, C36.2, C37.2, ISO3.3, J4.2, TP2.1, U14.5, U16.7, U22.2
/SCL_GLV: R27.2, TP9.1, U1.2, U5.28, U6.1, U7.6, U14.3, U15.3, U21.3
/SCL_SEG+: J3.3, R22.2, U15.6
/SCL_SEG-: J4.3, R21.2, U14.6
/SCL_TSV: R45.2, U2.2, U10.6, U21.6
/SDA_GLV: R23.2, TP8.1, U1.1, U5.27, U6.2, U7.5, U14.2, U15.2, U21.2
/SDA_SEG+: J3.4, R20.2, U15.7
/SDA_SEG-: J4.4, R19.2, U14.7
/SDA_TSV: R44.2, U2.1, U10.7, U21.7
/SLOOP1_IN: J10.4, K1.4, R5.2
/SLOOP1_OUT: J10.8, K1.3
/SLOOP2: J10.3, J10.7, R38.2
/~CHRG_DETECT: C42.1, R48.1, U5.30
unnamed: BT1.1, U7.3
unnamed: C3.1, U3.3
unnamed: C12.1, U8.6
unnamed: C15.1, D5.2, U9.3
unnamed: C23.1, Q5.1, R28.2, R29.1
unnamed: C33.1, U7.1, Y1.1
unnamed: C38.1, U7.2, Y1.2
unnamed: D1.2, K1.2, Q1.3
unnamed: D2.2, R7.2
unnamed: D3.2, R8.2
unnamed: D4.2, D7.1, K2.2, K3.2, Q2.3, R50.2
unnamed: D7.2, R41.2
unnamed: ISO2.1, Q5.3
unnamed: ISO2.2, R31.2
unnamed: ISO2.4, R33.1, R48.2
unnamed: ISO3.1, R42.1
unnamed: ISO4.1, R35.1
unnamed: ISO7.1, R43.1
unnamed: Q3.1, R49.2, R50.1
unnamed: R2.1, U19.1
unnamed: R4.2, U4.8
unnamed: R5.1, U19.5
unnamed: R24.2, U8.7
unnamed: R38.1, U19.3
unnamed: R46.1, U19.7
