Lafayette-FSAE/PacMan/(commit log)

2019-10-08 Created blank schematic
    [PacMan.kicad_pcb, PacMan.sch]
2019-11-08 lotsa work
    [PacMan.kicad_pcb, PacMan.sch]
2019-11-08 more files
    [CUI_V7805-500.step, Charging.sch, I2CIsolator.sch, MCU.sch, Power.sch, Sensors_Misc.sch]
2019-11-10 v0.1, basic components on schematic
    [CUI_V7805-500.step, Charging.sch, I2CIsolator.sch, MCU.sch, PacMan.sch, Power.sch, Sensors_Misc.sch]
2019-11-11 Additional components and connectors, resistor sizing, etc.
    [Charging.sch, I2CIsolator.sch, MCU.sch, PacMan.sch, Power.sch, Sensors_Misc.sch]
2019-11-11 New power monitor, panel outputs and filtering, shunt resistor
    [MCU.sch, PacMan.sch, Power.sch, Sensors_Misc.sch]
2019-11-12 Routed almost everything, general design mostly complete
    [Charging.sch, Isolation.sch, MCU.sch, PacMan.sch, Power.sch, Sensors_Misc.sch]
2019-11-13 Spec'd some parts
    [Charging.sch, I2CIsolator.sch, Isolation.sch, MCU.sch, PacMan.sch, Power.sch, Sensors_Misc.sch]
2019-11-13 Weird cache stuff
    [Charging.sch, Isolation.sch, MCU.sch, PacMan.sch, Power.sch]
2019-11-13 More part speccing
    [Charging.sch, Isolation.sch, MCU.sch, PacMan.sch, Power.sch]
2019-11-13 updated footprints
    [PacMan.kicad_pcb, PacMan.sch]
2019-11-14 Started work on board layout
    [Charging.sch, Isolation.sch, MCU.sch, PacMan.kicad_pcb, PacMan.sch, Power.sch]
2019-11-15 go on, look, see if I care
    [CUI_PDQE10-Q24-S9-D.step, CUI_PDQE10-Q48-S24-D.step, Charging.sch, DF22-1P-7.92DSA.stp, DF22-2P-7.92DSA.stp, G5Q_1A4.step, PacMan.kicad_pcb, PacMan.sch]
2019-11-18 added like 2 traces
    [PacMan.kicad_pcb]
2019-11-18 Changed/added some footprints for AIR and ChrgDetect connectors
    [PacMan.sch]
2019-11-18 Routing + 3D models
    [PacMan.kicad_pcb, PacMan.sch, molex_mini_fit_jr_2x1.stp, molex_mini_fit_jr_2x4.stp, molex_mini_fit_jr_2x6.stp]
2019-11-18 5ish more traces left wawaweewa
    [MCU.sch, PacMan.kicad_pcb]
2019-11-19 filled out some parts information
    [Charging.sch, Isolation.sch, MCU.sch, PacMan.kicad_pcb, PacMan.sch, Power.sch]
2019-11-19 0 unrouted babyyyyyyyyy
    [Charging.sch, Isolation.sch, MCU.sch, PacMan.kicad_pcb, PacMan.sch]
2019-11-19 Gerber files from first review/quote
    [PacMan-B_Cu.gbr, PacMan-B_Mask.gbr, PacMan-B_SilkS.gbr, PacMan-Edge_Cuts.gbr, PacMan-F_Cu.gbr, PacMan-F_Mask.gbr, PacMan-F_SilkS.gbr, PacMan.drl]
2019-11-19 GTD file
    [MCU.sch, PacMan.sch, Power.sch]
2019-11-19 Ordered board, GTD file, panelized gerbers
    [PacMan-B_Cu.gbr, PacMan-B_Mask.gbr, PacMan-B_SilkS.gbr, PacMan-Edge_Cuts.gbr, PacMan-F_Cu.gbr, PacMan-F_Mask.gbr, PacMan-F_SilkS.gbr, PacMan.drl]
2019-11-20 Created schematic pdf for 1.0
2019-12-04 Updated Things to fix and added a render file
    [MCU.sch]
2019-12-07 Added BOM, some PDFs, updated schematic version to 1.1 for updates
    [BOM 1.0.xlsx, Charging.sch, Isolation.sch, MCU.sch, PacMan.sch, Power.sch]
2019-12-09 Updated things to fix, output some new renders, updated schematic to 1.1 to start changing
    [PacMan.sch]
2020-01-04 Switched some pins around, added SLOOP isolators to measure SLOOP1in and SLOOP2
    [Charging.sch, Isolation.sch, MCU.sch, PacMan.sch, Power.sch]
2020-01-04 brought in the updated fuse footprint and cleaned up some tracks
    [PacMan.kicad_pcb]
2020-01-06 made the board smaller
    [MCU.sch, PacMan.kicad_pcb, PacMan.sch, Power.sch]
2020-01-07 starting the rework to fix the AMS isolation error
    [Charging.sch, Isolation.sch, MCU.sch, PacMan.sch, Power.sch]
2020-01-07 Updated date for version on PCB
    [PacMan.kicad_pcb]
2020-01-08 Switched the control loops for the charging relays to GLV
    [Charging.sch, Power.sch]
2020-01-10 Updated some power stuff
    [CUI_VIFSD1-S24-S5-SIP.step, Charging.sch, Isolation.sch, MCU.sch, PacMan.kicad_pcb, PacMan.sch, PacMan_old.kicad_pcb, Power.sch]
2020-01-11 Started work on new layout
    [Charging.sch, Isolation.sch, PacMan.kicad_pcb, PacMan.sch, Power.sch]
2020-01-11 quick change
    [Charging.sch, Isolation.sch, MCU.sch, PacMan.kicad_pcb, PacMan.sch, Power.sch]
2020-01-12 Added connectors for cell balancing, made big progress on new layout
    [Charging.sch, Isolation.sch, MCU.sch, PacMan.kicad_pcb, PacMan.sch, Power.sch]
2020-01-13 Just about finished the layout
    [MCU.sch, PacMan.kicad_pcb, PacMan.sch, Power.sch]
2020-01-13 Started adding active charge measurement
    [Charging.sch, PacMan.kicad_pcb, Power.sch]
2020-01-14 Added RTC onto board
    [Charging.sch, Isolation.sch, MCU.sch, PacMan.sch, Power.sch]
2020-01-14 Schematic work, placed some components on the PCB
    [Charging.sch, Isolation.sch, MCU.sch, PacMan.kicad_pcb, PacMan.sch, Power.sch]
2020-01-14 started moving over to new esp dev kit
    [MCU.sch, PacMan.kicad_pcb]
2020-01-15 Re-layout to account for the new esp32, put on the RTC, the balancing measurement stuff, pretty much finished up the board, added some comments to schematic and other changes
    [Charging.sch, Isolation.sch, MCU.sch, PacMan.kicad_pcb, PacMan.sch, Power.sch]
2020-01-15 switched some ESP32 pins around, hopefully fixed some grounding stuff, cleaned up schematic naming slightly
    [Charging.sch, Isolation.sch, MCU.sch, PacMan.kicad_pcb, PacMan.sch, Power.sch]
2020-01-17 Added connection to IO expander interrupt pin
    [Charging.sch, MCU.sch, PacMan.kicad_pcb, PacMan.sch, Power.sch]
2020-01-17 Added some planes around the balancing connectors and added the QRCode to the github page
    [PacMan.kicad_pcb]
2020-01-19 started re-routing for adjusted symmetric design
    [Isolation.sch, PacMan.kicad_pcb, PacMan.sch, Power.sch]
2020-01-20 incremental work
    [PacMan.kicad_pcb, Power.sch]
2020-01-20 Fixed a little bit of stuff
    [PacMan.kicad_pcb, PacMan.sch]
2020-01-21 completed reroute
    [Charging.sch, Isolation.sch, PacMan.kicad_pcb, PacMan.sch, Power.sch]
2020-01-21 updayed relayfootprint and fixed chassis trace
    [PacMan.kicad_pcb]
2020-01-21 Cleaned up some spacing, silkscreen, qrcode
    [PacMan.kicad_pcb]
2020-01-21 Added CellMen reset lines and routed them
    [Isolation.sch, MCU.sch, PacMan.kicad_pcb, PacMan.sch, Power.sch]
2020-01-22 quick track fix
    [PacMan.kicad_pcb]
2020-01-22 Output some gerber files and pushed some title block info
    [Charging.sch, Isolation.sch, MCU.sch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]
2020-01-22 Added panelized production files
    [PacMan-B_Cu.gbr, PacMan-B_Mask.gbr, PacMan-B_SilkS.gbr, PacMan-Edge_Cuts.gbr, PacMan-F_Cu.gbr, PacMan-F_Mask.gbr, PacMan-F_SilkS.gbr, PacMan.drl]
2020-01-22 changed date, added i2c address
    [MCU.sch]
2020-01-24 made some holes NPTH, exported some new gerbers
    [PacMan-B_Cu.gbr, PacMan-B_Mask.gbr, PacMan-B_SilkS.gbr, PacMan-Edge_Cuts.gbr, PacMan-F_Cu.gbr, PacMan-F_Mask.gbr, PacMan-F_SilkS.gbr, PacMan-NPTH.drl]
2020-01-30 added some dimensions and fixed the silkscreen slot
    [PacMan.kicad_pcb]
2020-02-04 added emergency gerber files, yay
    [PacMan-B_Cu.gbr, PacMan-B_Mask.gbr, PacMan-B_SilkS.gbr, PacMan-Edge_Cuts.gbr, PacMan-F_Cu.gbr, PacMan-F_Mask.gbr, PacMan-F_SilkS.gbr, PacMan-NPTH.drl]
2020-02-04 switched to new holes instead of slots, more gerbers
    [PacMan-B_Cu.gbr, PacMan-B_Mask.gbr, PacMan-B_SilkS.gbr, PacMan-Edge_Cuts.gbr, PacMan-F_Cu.gbr, PacMan-F_Mask.gbr, PacMan-F_SilkS.gbr, PacMan.drl]
2020-02-04 jk here's the change
    [PacMan.kicad_pcb]
2020-02-11 updated resistor values
    [Charging.sch, Isolation.sch, MCU.sch, PacMan.sch, Power.sch]
2020-02-13 Fixed the upside down PMOS transistors
    [Isolation.sch, PacMan.sch]
2020-02-20 Updated schematic with new names for SEG1 and SEG2, added temp sensor, added the 5V converter 3D model
    [Charging.sch, Isolation.sch, MCU.sch, PacMan.sch, Power.sch, mps_dcdc_mef1s_sp3c_a.step]
2020-02-21 Updated PCB design to match schematic changes, played with spacings
    [Charging.sch, Isolation.sch, MCU.sch, PacMan.kicad_pcb, PacMan.sch, Power.sch]
2020-02-24 added GLV measurement point, switched to a 16 pin 4 in 1 isolator
    [MCU.sch, PacMan.kicad_pcb, PacMan.sch]
2020-02-26 added filter cap to ADC measurement channel
    [Charging.sch, PacMan.kicad_pcb]
2020-03-05 Fixed the issue with the ADC pins (VP and VN), did some rerouting, slight silkscreen changes
    [Charging.sch, Isolation.sch, MCU.sch, PacMan.kicad_pcb, PacMan.sch, Power.sch]
2020-03-05 quick little routing thing
    [PacMan.kicad_pcb]
2020-03-05 a bit of dimensioning
    [PacMan.kicad_pcb]
2020-03-12 Maybe final version of PacMan
    [Charging.sch, Isolation.sch, MCU.sch, PacMan.kicad_pcb, PacMan.sch, Power.sch]
2020-03-30 Removed some old files
    [PacMan_old.kicad_pcb]
2020-04-09 Added comments to the schematic, changed some formatting, made the charge LED a high side switch, some small value changes, layout update
    [Charging.sch, Isolation.sch, MCU.sch, PacMan.kicad_pcb, PacMan.sch, Power.sch]
2020-04-09 added BOM and render file
    [MCU.sch, PacMan_v_1_3_BOM.xlsx]
2020-04-14 Added 3D models for connectors, relabeled some connectors
    [39281083.stp, 39281123.stp, Anderson_2x1.step, Charging.sch, Isolation.sch, MCU.sch, PacMan.kicad_pcb, PacMan.sch]
2020-04-14 added some mates with fields for the connectors
    [PacMan.sch]
